DuvanRamirez/CubeSat_UD34/P2 – OBC-ADCS/Entregas/esquematico_P2.pdf

# CubeSat UD34 – PCB P2 OBC-ADCS

## Esquemático completo (Práctica 4) – proyecto Altium P2_OBC-ADCS.PrjPcb

## Autores: Duvan Camilo Ramírez Caro · Daniela Escobar Velandia Fecha: 2026-10-26 · Revisión: v1.0-esquematico

## Contenido

Hoja 2/10 P2_TOP.SchDoc – Hoja principal: bloques e interconexiones (multicanal Repeat(MTQ,1,3) y Repeat(PANEL,1,4)) Hoja 3/10 PWR_IN.SchDoc – Entrada de potencia: J2 (H2 del PC/104), desacoplo de rieles y puntos de prueba
Hoja 4/10 MCU_CORE.SchDoc – MCU STM32H743IIT6 (U1A, U1B, U1C), cristal HSE, SWD (J9), desacoplo, VDDA/VREF+ Hoja 5/10 MEMORY.SchDoc – SDRAM IS42S16160L (FMC), eMMC IS21EF04GP (SDMMC1) y NOR W25Q128JV (QUADSPI)

### Hoja 6/10 CAM_IF.SchDoc – Interfaz de cámara: J3 FFC de 40 pines a la P4, pull-ups I2C3

Hoja 7/10 ADCS_SENS.SchDoc – Sensores: IMU ISM330DHCX (SPI1), magnetómetro LIS2MDL y RTC RV-3032 (I2C2) Hoja 8/10 BUS_IF.SchDoc – Bus del satélite J1 (H1 del PC/104), ruedas de reacción J8, pull-ups y puntos de prueba

### Hoja 9/10 MTQ_CH.SchDoc – Canal de magnetorquer (×3): DRV8837 + INA180A2 + shunt 0,47 Ω

Hoja 10/10 PANEL_CH.SchDoc – Canal de panel (×4): conector JST GH, filtros RC de sensores solares, bobina

Nota: las hojas de este documento son capturas de pantalla del editor de Altium Designer (2026-10-26), no la exportación Smart PDF.
Los canales repetidos (MTQ1–MTQ3, PANEL1–PANEL4) se muestran con su hoja única; la versión exportada se reemplazará en la siguiente revisión.


P2 OBC-ADCS · P2_TOP.SchDoc | Hoja principal: bloques e interconexiones (multicanal Repeat(MTQ,1,3) y Repeat(PANEL,1,4))
CubeSat UD34 · Ramírez Caro, Escobar Velandia · 2026-10-26 · v1.0-esquematico | Hoja 2 de 10


P2 OBC-ADCS · PWR_IN.SchDoc | Entrada de potencia: J2 (H2 del PC/104), desacoplo de rieles y puntos de prueba
CubeSat UD34 · Ramírez Caro, Escobar Velandia · 2026-10-26 · v1.0-esquematico | Hoja 3 de 10

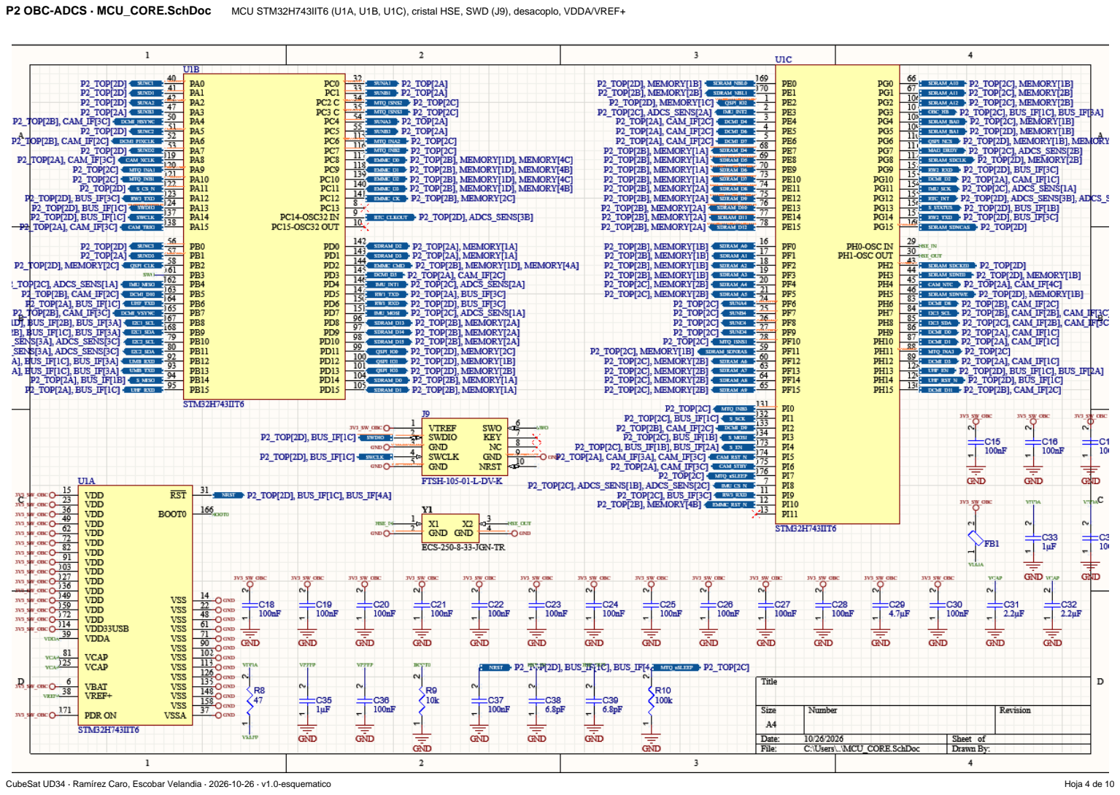
[picture p16: page 4]

P2 OBC-ADCS · MCU_CORE.SchDoc | MCU STM32H743IIT6 (U1A, U1B, U1C), cristal HSE, SWD (J9), desacoplo, VDDA/VREF+
CubeSat UD34 · Ramírez Caro, Escobar Velandia · 2026-10-26 · v1.0-esquematico | Hoja 4 de 10

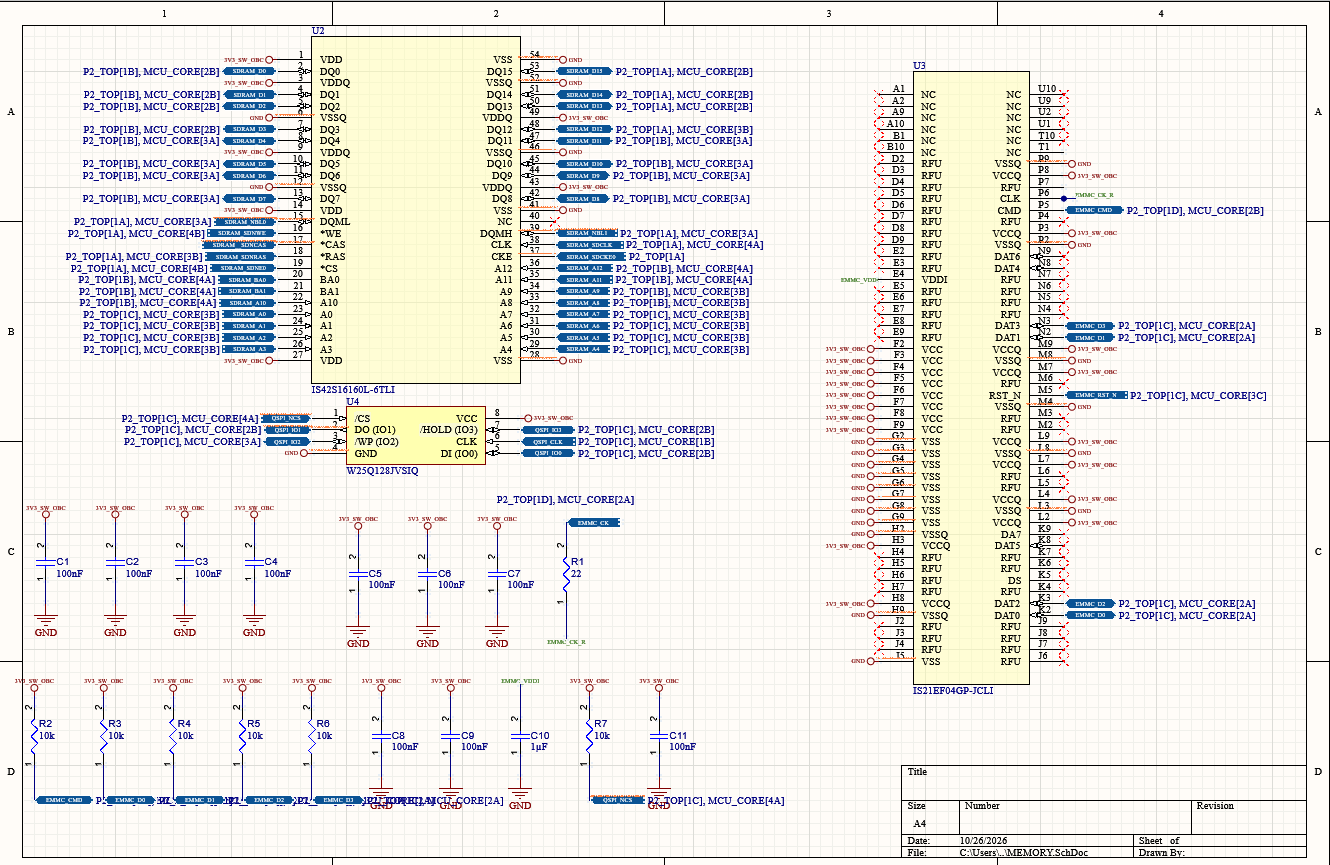
[picture p17: page 5]

P2 OBC-ADCS · MEMORY.SchDoc | SDRAM IS42S16160L (FMC), eMMC IS21EF04GP (SDMMC1) y NOR W25Q128JV (QUADSPI)
CubeSat UD34 · Ramírez Caro, Escobar Velandia · 2026-10-26 · v1.0-esquematico | Hoja 5 de 10


P2 OBC-ADCS · CAM_IF.SchDoc | Interfaz de cámara: J3 FFC de 40 pines a la P4, pull-ups I2C3
CubeSat UD34 · Ramírez Caro, Escobar Velandia · 2026-10-26 · v1.0-esquematico | Hoja 6 de 10


P2 OBC-ADCS · ADCS_SENS.SchDoc Sensores: IMU ISM330DHCX (SPI1), magnetómetro LIS2MDL y RTC RV-3032 (I2C2)

CubeSat UD34 · Ramírez Caro, Escobar Velandia · 2026-10-26 · v1.0-esquematico | Hoja 7 de 10


P2 OBC-ADCS · BUS_IF.SchDoc | Bus del satélite J1 (H1 del PC/104), ruedas de reacción J8, pull-ups y puntos de prueba
CubeSat UD34 · Ramírez Caro, Escobar Velandia · 2026-10-26 · v1.0-esquematico | Hoja 8 de 10


P2 OBC-ADCS · MTQ_CH.SchDoc | Canal de magnetorquer (×3): DRV8837 + INA180A2 + shunt 0,47 Ω
CubeSat UD34 · Ramírez Caro, Escobar Velandia · 2026-10-26 · v1.0-esquematico | Hoja 9 de 10


P2 OBC-ADCS · PANEL_CH.SchDoc | Canal de panel (×4): conector JST GH, filtros RC de sensores solares, bobina
CubeSat UD34 · Ramírez Caro, Escobar Velandia · 2026-10-26 · v1.0-esquematico | Hoja 10 de 10
