DuvanRamirez/CubeSat_UD34/Diagramas/diagrama_arquitectura.png

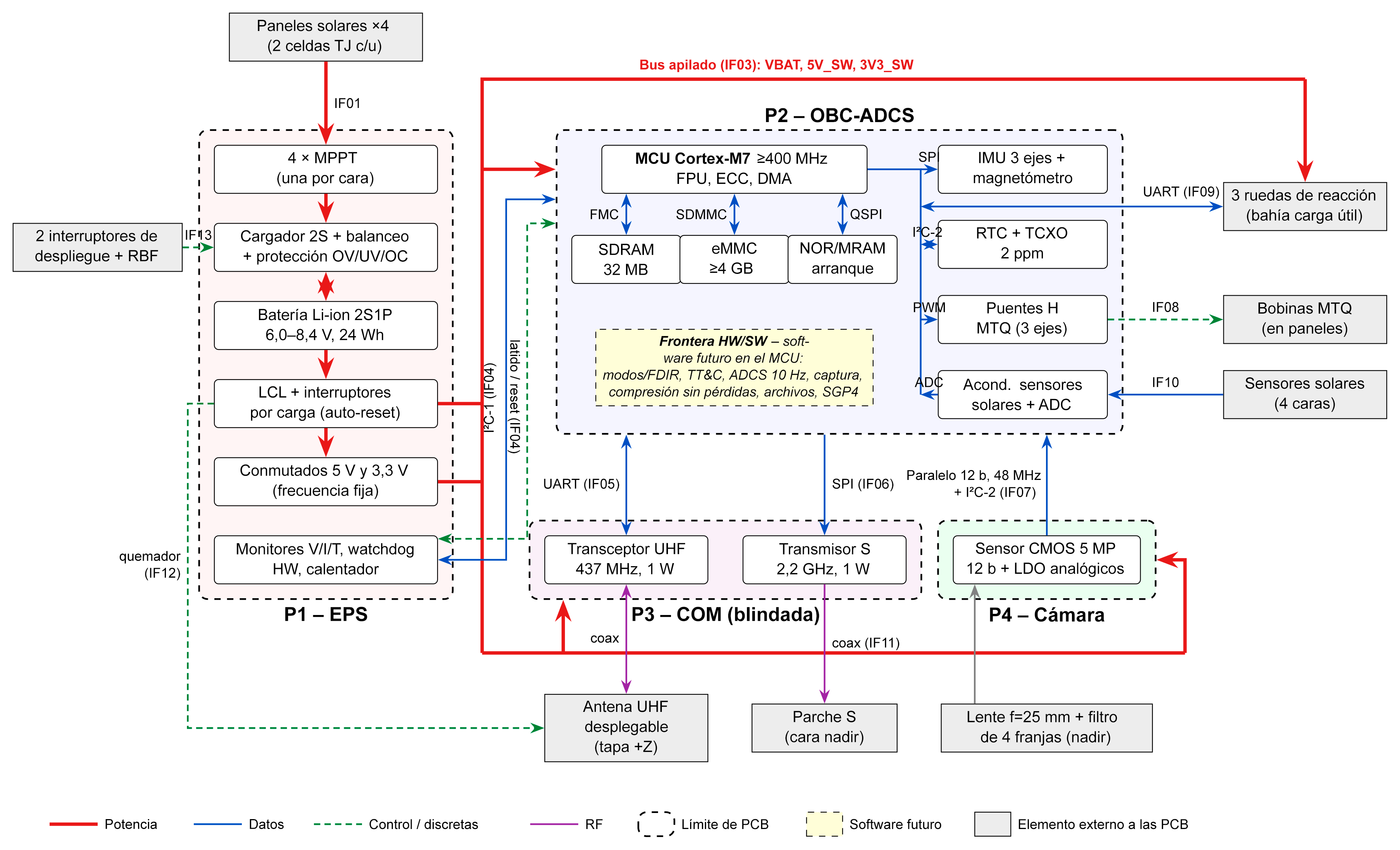
Diagramas/diagrama_arquitectura.png
