DuvanRamirez/CubeSat_UD34/Hoja_calculo/Hoja_Calculo.xlsx

Sheet: Leeme
CubeSat UD34 – Práctica 3: hoja de cálculo de soporte
Contiene las matrices, la comparación de alternativas y los presupuestos del informe.
Convención de colores: texto azul = dato de entrada editable; negro = fórmula; verde = vínculo a otra hoja; relleno amarillo = supuesto clave.
Hojas: Parametros (entradas y cálculos de órbita y carga útil) · Requisitos · Especificaciones · Trazabilidad · HW_SW · Recursos · Alternativas · Matriz (ponderada y sensibilidad) · Potencia · Masa_Volumen · Datos · Enlace · Interfaces · Riesgos.
Referencias entre corchetes: [proyecto] descripción del proyecto UD34; [cds] CubeSat Design Specification Rev. 14.1; [soapwr], [soagnc], [soaav], [soacom] NASA State-of-the-Art, cap. 3, 5, 8 y 9; [ecss20], [ecssemc], [ecsspcb] normas ECSS; [nasa41], [nasa42] NASA SE Handbook.
Los contactos con Medellín (pases/día y minutos/día) provienen de la propagación de 10 días en calculos.py; aquí se ingresan como dato.

Sheet: Parametros
Parámetro | Valor | Unidad | Fuente / fórmula
Parámetro gravitacional terrestre μ | 398600.442 | km³/s² | Constante
Radio terrestre ecuatorial | 6378.137 | km | Constante
Coeficiente J2 | 0.001 | - | Constante
Altitud orbital | 550 | km | [proyecto]
Semieje mayor | 6928.137 | km | Re + h
Período orbital | 95.650 | min | 2π√(a³/μ)
Velocidad de la traza | 6.983 | km/s | √(μ/a)·Re/a
Inclinación heliosíncrona | 97.593 | ° | Precesión nodal J2 = 360°/año
Fracción de eclipse (β = 0) | 0.372 | - | Peor caso (S-02)
Duración del eclipse | 35.611 | min
Órbitas por día | 15.055 | -
Tamaño de píxel | 2.200 | µm | Sensor CMOS 5 MP (ET-05)
Distancia focal | 25 | mm | Lente (ET-03)
Columnas leídas (ventana) | 1296 | px | ET-04
Filas del sensor | 1944 | px | ET-05
Bits por píxel | 12 | bit | ET-02
Número de bandas | 4 | - | RF-01
GSD en nadir | 48.400 | m | H·p/f (Ec. 1)
Ancho de franja | 62.726 | km | Ncol·GSD
Filas por banda | 486.000 | px
Longitud de franja por banda | 23.522 | km
Datos por toma (crudo) | 3.779 | MB
Intervalo entre tomas | 3 | s | ET-06
Duración de la escena objetivo | 60 | s | ET-06
Tomas por sesión | 26.000 | - | Escena + barrido de las 4 franjas
Razón de compresión sin pérdidas | 2 | - | S-05
Volumen por sesión (comprimido) | 49.129 | MB
Traslape entre tomas | 0.109 | - | Debe ser > 0
Exposición máxima | 3.466 | ms | Ec. 2
Reloj de píxel | 48 | MHz | ET-07
Tiempo de lectura | 52.488 | ms
Estabilidad máxima | 0.048 | °/s | Ec. 3
Cizalla por rolling shutter | 7.573 | px | Se corrige en tierra
Ciclos por muestra de compresión | 700 | ciclos | S-06 (Emporda: 550-710)
Reloj de CPU | 400 | MHz | ET-10
Tiempo de compresión por toma | 4.409 | s
Compresión de una sesión (diferida) | 1.911 | min | Debe terminar antes del siguiente contacto
Desplazamiento por 2° de error | 19.206 | km | RNF-07
Pases por día sobre Medellín (el ≥ 10°) | 2.200 | pases/día | calculos_ud34.py (10 días)
Tiempo de contacto por día | 15.400 | min/día | calculos_ud34.py (10 días)
Fracción útil del contacto para banda S | 0.500 | - | Presupuesto de datos
Eficiencia de trama | 0.850 | - | Presupuesto de datos
Tasa de banda S | 1 | Mbps | ET-12
Capacidad útil de banda S | 49.087 | MB/día | ET-14
Tiempo S por sesión | 7.706 | min
Sesiones por semana | 4 | - | S-07

Sheet: Supuestos
ID | Supuesto | Justificación / consecuencia
S-01 | Órbita circular heliosíncrona de 550 km, i=97,6°, hora local del nodo descendente 10:30. | i calculada con la condición de precesión nodal J_2 (archivos de soporte). Coincide con la de AlAinSat-1, en SSO a 550 km (i=97,565°) [alainsat]. La hora 10:30 es la de Sentinel-2, elegida como compromiso entre iluminación y nubosidad [s2orbit].
S-02 | Eclipse de peor caso: 35,6 min de 95,6 min (β=0). | Dimensiona batería y promedio de generación de forma conservadora.
S-03 | Estación de referencia en Medellín (6,25°N, 75,56°W), elevación mínima 10°; UHF: Yagi 16,3 dBi, 120 W, receptor con NF 2 dB; banda S: parábola de 2 m con G/T=4,9 dB/K. | La estación no se diseña; se toman los parámetros de un kit comercial de estación para pequeños satélites [isisgs,ntnugs]. La antena UHF se toma a T_0=290 K (conservador). Si solo hubiera parábola de 1,2 m, ver riesgo R-05.
S-04 | No se usa receptor GNSS; la posición se propaga a bordo con SGP4 a partir de TLE cargados desde tierra. | El error de TLE+SGP4 crece del orden de 1--3 km/día [sgp4]; con TLE nuevos cada ≤48 h el error queda ≤7 km, menor que media franja (31 km). Se ahorra la potencia y el volumen de un receptor.
S-05 | Compresión sin pérdidas a bordo con razón 2:1. | CCSDS-123 es el estándar de compresión sin pérdidas para imágenes multiespectrales [ccsds120]; su implementación en ECOSTRESS logra típicamente 2,3:1 [kiely]. Con una razón de solo 1,5:1 una sesión ocupa 65,5 MB, se descarga en 1,3 días (<2, RNF-05) y 7 días ocupan 0,46 GB (<1 GB, ET-08): la arquitectura no cambia.
S-06 | Costo de compresión en software de 700 ciclos de reloj por muestra. | La implementación de referencia de CCSDS-123 (Emporda) procesa ≈4,9 Msamples/s en un i7-7500U con 15 bandas de predicción [fjeldtvedt], es decir, ≈550--710 ciclos/muestra; se toma el valor alto. La compresión se hace después de la sesión desde memoria (Tabla recursos), por lo que un costo mayor solo alarga ese tiempo.
S-07 | Operación nominal de 4 sesiones de captura por semana; picos de 1 sesión/día. | Coherente con la capacidad de descarga (Sección presupuestos) y con la nubosidad de la zona.
S-08 | Consumos, masas y tamaños tomados de productos de la misma clase: Tablas 3-1, 3-4 y 3-8 [soapwr], 5-3 a 5-7 [soagnc], 8-4 [soaav], 9-2 y 9-3 [soacom] y hojas de datos de referencia (Tabla pot). | Nivel suficiente para demostrar viabilidad; se añade 20 % de margen. La masa de la óptica es la única estimación propia.
S-09 | Temperatura interna de operación entre -20 °C y +50 °C. | Es el rango de ciclado térmico del estándar QB50 usado para CubeSats [alainsat] y el rango de operación exigido a radios CubeSat de NASA [altunc]. No se hace análisis térmico (no exigido [proyecto]).
S-10 | Altura útil de apilado interno de 95 mm. | Una estructura 1U comercial ofrece un volumen interior de 98,4 mm de altura [spacemanic]; se reservan 3,4 mm para holguras y fijaciones. Condiciona la partición física (R-01).
S-11 | Misión de 6 meses en LEO: componentes COTS de rango industrial con mitigación de efectos de evento único. | Práctica usual en CubeSats; hay OBC Cortex-M7 comerciales probados hasta 40 krad, y las mitigaciones recomendadas son watchdog, ECC y reinicio de alimentación [soaav]. El proyecto no exige análisis de radiación [proyecto].
S-12 | Registro entre bandas, corrección geométrica y calibración radiométrica se realizan en tierra. | Libera al OBC de procesamiento de imagen complejo.
S-13 | Para BER 10^-5: bajada UHF GMSK con detección coherente, E_b/N_0=9,6 dB; bajada S con QPSK y código convolucional (7,1/2), 4,1 dB; subida UHF, sensibilidad del receptor de -104 dBm (FSK, 9,6 kbps). | MSK con detección coherente tiene el desempeño de BPSK y GMSK con BT=0,5 lo degrada poco [murota]; el código (7,1/2) gana ≈5,5 dB sobre el caso sin codificar (9,6 dB) [ccsds130]; la sensibilidad es la de un transceptor CubeSat comercial [trxvu]. Con 1 dB adicional de pérdida de implementación todos los márgenes siguen ≥3 dB.
S-14 | Consumo de las radios: transmisor UHF 5,5 W a 30 dBm; transmisor S 5 W a 30 dBm; receptor UHF 0,24 W. | Transceptores UHF comerciales consumen 3--5,5 W para 27--33 dBm (se toma el máximo) [pulsarvutrx] y <0,24 W en recepción [pulsarutrx]; un transmisor S de 2,2--2,3 GHz con QPSK y 1 Mbps útiles con r=1/2 consume <5 W a 30 dBm [pulsarstx].

Sheet: Requisitos
ID | Tipo | Requisito | Origen / justificación | Pr. | Criterio de aceptación (método)
Funcionales
RF-02 | F | El satélite deberá ejecutar sesiones de captura programadas desde tierra por tiempo y objetivo. | ConOps; las zonas cafeteras solo son visibles en algunos pases. | A | Plan con 3 capturas ejecutado en banco con tiempo simulado, error de disparo ≤10 ms (D).
RF-03 | F | El satélite deberá conservar imágenes y telemetría en memoria no volátil hasta confirmar su descarga. | Contactos intermitentes (≈2,2 pases/día). | A | Sin pérdida de archivos tras 10 cortes de energía durante escritura (P).
RF-04 | F | El satélite deberá transmitir los datos de imagen a la estación de Medellín. | Misión. | A | Transferencia de extremo a extremo con atenuador que reproduce la pérdida de ET-12, tasa de error de trama <10^-3 (P).
RF-05 | F | El satélite deberá transmitir telemetría de tensiones, corrientes, temperaturas, modo y estado de subsistemas. | Descripción del proyecto. | A | Todas las variables de la lista de telemetría presentes en la baliza y en el volcado (D).
RF-06 | F | El satélite deberá recibir, validar y ejecutar telecomandos y reportar su ejecución. | Descripción del proyecto. | A | 100 % de comandos válidos ejecutados y reconocidos; comandos corruptos rechazados (P).
RF-07 | F | El satélite deberá estimar su actitud. | Apuntar cámara, antena y paneles. | A | Sensores entregan datos a la tasa de ET-17; estimación verificada por simulación (A, P).
RF-08 | F | El satélite deberá modificar su actitud para amortiguar la rotación, apuntar la cámara, apuntar la antena a la estación y exponer los paneles al Sol. | Descripción del proyecto. | A | Polaridad y par de actuadores medidos (P); desempeño por simulación (A).
RF-09 | F | El satélite deberá generar energía solar y almacenarla para operar en eclipse. | Descripción del proyecto. | A | Carga de batería con simulador solar en rango de ET-19/20 (P).
RF-10 | F | El satélite deberá permitir encender y apagar por comando cada subsistema no crítico. | Gestión de energía y recuperación de fallas. | A | Cada salida conmutada responde a comando (P).
RF-11 | F | El satélite deberá proteger cada línea de alimentación contra sobrecorriente y restablecerla automáticamente. | Latch-up por radiación [soaav]; ECSS-E-ST-20 §5.8.1d,e [ecss20]. | A | Corto inducido: disparo y reconexión en tiempos de ET-22 sin afectar otras líneas (P).
RF-12 | F | El satélite deberá mantener la hora y estimar su posición orbital a bordo. | Programar capturas y pases sin GNSS (S-04). | M | Error de hora dentro de RNF-13 (P); SGP4 comparado con referencia (A).
RF-13 | F | El satélite deberá pasar autónomamente a modo seguro ante batería baja, bloqueo del OBC o 48 h sin comandos. | Protección de la misión. | A | Inyección de las tres fallas produce transición a modo seguro (D).
RF-14 | F | El satélite deberá pasar de configuración de lanzamiento a operativa de forma autónoma tras la separación. | Antena UHF plegada durante el lanzamiento. | A | Secuencia completa en banco activando los interruptores de despliegue (D).
No funcionales
RNF-02 | NF | El ancho de franja por banda deberá ser ≥50 km. | Absorber el error de apuntamiento (19 km a 2°) y cubrir la región en un pase. | A | Cálculo con número de columnas (A).
RNF-03 | NF | La resolución radiométrica deberá ser ≥10 bits. | Diferencias pequeñas de reflectancia entre estados de vegetación. | M | Hoja de datos del sensor (I).
RNF-04 | NF | El almacenamiento deberá guardar ≥7 días de capturas nominales sin descarga. | Pérdida de pases o indisponibilidad de la estación. | A | Capacidad útil ≥ ET-08 (A, I).
RNF-05 | NF | El sistema deberá descargar el volumen de una sesión en ≤2 días de contactos. | Equilibrio entre generación y descarga de datos (MOE-2). | A | Presupuesto de enlace y contactos (A).
RNF-06 | NF | Todos los enlaces deberán tener margen ≥3 dB a 10° de elevación. | Margen estándar de enlace usado por NASA para CubeSats [altunc]. | A | Presupuesto de enlace (A).
RNF-07 | NF | El error de apuntamiento de la cámara deberá ser ≤2° (3σ) durante la captura. | Desplazamiento ≤19 km, menor que media franja. | A | Simulación ADCS con sensores de ET-17 (A).
RNF-08 | NF | La estabilidad angular durante la captura deberá ser ≤0,04 °/s. | Cizalla por lectura rolling < GSD/2 (Ec. est). | A | Simulación ADCS (A).
RNF-09 | NF | El balance de energía diario deberá ser positivo con margen de 20 % sobre el consumo en el perfil de peor caso. | Viabilidad energética. | A | Presupuesto de potencia (A).
RNF-10 | NF | La profundidad de descarga de la batería deberá ser ≤20 % en la órbita de peor caso. | ≈2750 ciclos en 6 meses. | M | Presupuesto (A); ciclo de carga en banco (P).
RNF-11 | NF | El satélite deberá cumplir sus funciones durante al menos 6 meses. | Supuesto obligatorio de la misión. | A | Degradación de paneles y ciclos de batería incluidos en los presupuestos (A).
RNF-12 | NF | El procesamiento deberá ejecutar el control de actitud a ≥10 Hz con carga de CPU ≤70 % durante la captura y comprimir una sesión antes del siguiente contacto. | Margen para el software futuro [soaav]. | A | Estimación (A) y medición en tarjeta de evaluación (P).
RNF-13 | NF | El error de la hora a bordo deberá ser ≤0,5 s entre sincronizaciones. | 1 s de error equivale a 7 km a lo largo de la traza. | M | Deriva medida en 48 h (P).
RNF-14 | NF | Un supervisor independiente deberá reiniciar el OBC en ≤30 s si deja de responder. | El OBC es un punto único de falla. | A | Bloqueo forzado del OBC (P).
RNF-15 | NF | Cada PCB deberá poder alimentarse, programarse y probarse de forma independiente. | Integración y prueba (Práctica 6). | M | Prueba de cada tarjeta aislada con fuente de banco (D).
Ambientales
RA-02 | Am | El hardware deberá disipar su calor sin convección. | Vacío. | A | Elementos >0,5 W con camino térmico a estructura (A, I).
RA-03 | Am | El hardware deberá tolerar SEL y SEU sin pérdida permanente de funciones durante la misión. | Radiación en LEO; SEL destructivo en COTS [soaav]. | A | Mitigaciones de ET-22 y ET-24 implementadas (I); prueba de corto inducido (P).
RA-04 | Am | El hardware deberá soportar la vibración y el choque del lanzamiento. | CDS §3.1, §3.3 [cds]. | A | Niveles del proveedor o GEVS; en el curso: sujeción de componentes pesados (I).
RA-05 | Am | Las emisiones internas no deberán degradar la sensibilidad del receptor UHF más de 1 dB. | Pequeño frente al margen UHF (12,4 dB). ECSS-E-ST-20-07 [ecssemc]. | A | Piso de ruido con todos los subsistemas encendidos (P).
Normativos
RN-02 | N | Masa ≤2,00 kg y centro de masa a ±2 cm del centro geométrico. | CDS §2.2.10, §2.2.11. | A | Pesaje y cálculo de CG (I, A).
RN-03 | N | Energía cortada desde la entrega hasta el despliegue por interruptor(es) de despliegue y pin RBF; reinicio a estado de prelanzamiento si el interruptor conmuta. | CDS §2.3.1, §2.3.2, §2.3.5. | A | Prueba de continuidad y de secuencia (P).
RN-04 | N | Tres inhibidores independientes de RF y ninguna emisión antes de 45 min. | CDS §2.3.7, §2.4.5. | A | Inspección del esquema y prueba de temporización (I, P).
RN-05 | N | Tres inhibidores para elementos desplegables y espera ≥30 min. | CDS §2.3.8, §2.4.4. | A | Inspección y prueba (I, P).
RN-06 | N | Protección de carga y descarga de la batería contra celdas desbalanceadas. | CDS §2.3.6. | A | Prueba de protección (P).
RN-07 | N | Uso de frecuencias con licencia o coordinación (UIT, ANE; IARU para aficionados). | CDS §2.4.1, §2.4.2; [soacom]. | A | Trámite documentado (I).
RN-08 | N | Materiales con TML ≤1 % y CVCM ≤0,1 %. | CDS §2.1.7. | M | Lista de materiales contra base NASA (I).
RN-09 | N | Mitigación de desechos: componentes que reingresen con <15 J. | CDS §2.4.3. | M | Análisis con DAS (A).
RN-10 | N | Diseño eléctrico y de PCB conforme, como guía, a ECSS-E-ST-20C, ECSS-E-ST-20-07C y ECSS-Q-ST-70-12C. | Buenas prácticas [ecss20,ecssemc,ecsspcb]. | M | Lista de verificación en revisión de diseño (I).

Sheet: Especificaciones
ID | Requisitos | Parámetro | Valor / rango (unidad) | Fundamento | Verificación
ET-01 | RF-01 | Bandas (centro/ancho) | 560/35, 665/30, 705/15, 842/115 nm | Bandas visibles e infrarrojas para vegetación [proyecto]. Centros y anchos iguales a las bandas B3, B4, B5 y B8 de Sentinel-2 [s2bands,s2hub], lo que permite comparar los índices con ese sensor: verde, rojo (absorción de la clorofila), borde rojo y NIR. | I (filtro)
ET-02 | RNF-03 | Cuantización | 12 bits | Supera el mínimo de 10 bits; ADC de 12 bits del sensor de referencia [mt9p031]. | I
ET-03 | RNF-01 | GSD nadir | 48,4 m (±1 m por tolerancia de focal ±2 %) | Ec. gsd. | A
ET-04 | RNF-02 | Franja | 62,7 km (1296 columnas) | 1296×GSD; margen de 25 %. | A
ET-05 | RF-01, RF-02 | Toma | 1296×1944 px, 4 franjas de 486 filas, 3,78 MB | Sensor de 2592×1944 px de 2,2 µm con lectura por ventana [mt9p031]; 12 bits empaquetados. | A
ET-06 | RF-02, RNF-01 | Exposición / intervalo / sesión | ≤3,5 ms / 3 s / 26 tomas (≈75 s) | Ec. exp; avance 20,9 km < franja de banda 23,5 km (11 % traslape). | A, D
ET-07 | RF-01 | Interfaz de la cámara | Paralela 12 bits, PIXCLK ≤48 MHz, HSYNC/VSYNC; configuración I2C | 48 Mp/s con E/S de 1,8 V [mt9p031]; 96 MB/s por DMA a SDRAM; lectura 52 ms. | P
ET-08 | RF-03, RNF-04 | Almacenamiento masivo | ≥1 GB útil, no volátil con ECC | 7 días × 49 MB + telemetría = 347 MB, margen ×3 (bloques dañados, copias). | A
ET-09 | RNF-12 | RAM de trabajo externa | ≥16 MB (se elige 32 MB, 16 bits) | 3 tomas de 5,04 MB en palabras de 16 bits (doble búfer + compresión). | A
ET-10 | RNF-12 | Capacidad de CPU | ≥400 MHz clase Cortex-M7 con FPU; carga en captura ≈10 %; compresión de una sesión ≤3 min | S-06: 700×1296×1944 ciclos = 4,4 s/toma, 26 tomas en ≈2 min en segundo plano; ADCS y C&DH con 10 % reservado (≈85 de 856 DMIPS a 400 MHz [stm32]). | A, P
ET-11 | RNF-12, RNF-14 | Memoria de programa | ≥1 MB con ECC + 2 imágenes de arranque | Dos imágenes de arranque (RNF-14); MCU de referencia con 2 MB de flash y 1 MB de RAM [stm32]. | I
ET-12 | RF-04, RNF-05/06 | Enlace de datos | 2200--2290 MHz, 1 Mbps, QPSK + FEC r=1/2, 30 dBm; margen 4,8 dB | Ec. link, Tabla link; transmisores S de 27--33 dBm en 2200--2290 MHz y parches de 6 dBi (Tablas 9-2 y 9-3) [soacom,pulsarstx]. | A
ET-13 | RF-05/06, RNF-06 | Enlace TT&C | 435--438 MHz, semidúplex, 9,6 kbps (bajada GMSK, subida FSK), 30 dBm; márgenes 12,4 dB (bajada) y 12,7 dB (subida) | Tabla link; transceptores UHF de 27--33 dBm a 9,6 kbps (Tabla 9-3) [soacom,pulsarutrx]. | A
ET-14 | RNF-05 | Volumen descargable | ≥49 MB/día (50 % de contactos útiles) | Una sesión en 7,7 min de banda S; 4 sesiones/semana usan 57 %. | A
ET-15 | RNF-07 | Apuntamiento | ≤2° (3σ); conocimiento ≤1°; hasta 30° fuera de nadir | Ec. geométrica H; seguimiento de estación a ≤0,8 °/s. | A
ET-16 | RNF-08, RF-08 | Estabilidad y actuación fina | ≤0,04 °/s; 3 ruedas con ≥0,5 mNms c/u | Ec. est. Seguimiento requiere I=0,03 mNms (I≈0,002 kg·m²): margen >10. Ruedas de 0,58 mNms, ≤25 g (Tabla 5-3) [soagnc]. | A
ET-17 | RF-07 | Sensores de actitud | Magnetómetro y giróscopo 3 ejes a ≥10 Hz; sensores solares en 4 caras, ≤1° | Las capturas ocurren siempre con Sol: Sol + campo magnético dan actitud 3 ejes. Hay sensores solares analógicos de 0,2° sin consumo y magnetómetros de 0,01--0,23 W (Tablas 5-6 y 5-7) [soagnc]. | P
ET-18 | RF-08 | Magnetorquers | 3 ejes, ≥0,2 A·m² | Par mB=6 µN·m (B≈30 µT); frena 10°/s en <1 órbita. Existen de 0,2 A m², 16,5 g, 0,49 W (Tabla 5-4) [soagnc]. | A
ET-19 | RF-09, RNF-09 | Generación | 4 caras × 2 celdas TJ ≥29,5 %: 2,42 W/cara BOL; 1,51 W promedio EOL | Ec. pgen; 3G30-Adv, 29,5 % (Tabla 3-1) [soapwr]. | A, P
ET-20 | RF-09, RNF-10 | Batería | Li-ion 2S1P (18650), 6,0--8,4 V, ≥23 Wh; DoD peor órbita 11 % | Eclipse + déficit de peor órbita = 2,6 Wh; NCR18650B de 3350 mAh (Tabla 3-4) [soapwr] ⇒ 24,1 Wh. | A, P
ET-21 | RF-10 | Rieles | VBAT 6,0--8,4 V; 5,0 V ±3 % ≥1,2 A; 3,3 V ±3 % ≥1,0 A; rizado ≤30 mV_pp | Cargas pico 5 V: 0,58 A; 3,3 V: 0,45 A; factor 2. Radios en VBAT. | P
ET-22 | RF-11, RA-03 | Limitadores (LCL) | Uno por carga; umbral 1,3--1,5× I_max; disparo ≤1 ms; reconexión automática tras 100 ms | ECSS-E-ST-20 §5.8.1d (protección en la fuente) y §5.8.1e (sin desconexión permanente por SEE) [ecss20]. | P
ET-23 | RF-12, RNF-13 | Base de tiempo | RTC con TCXO ≤2 ppm; sincronización ≤ cada 48 h | Deriva máx. 0,35 s en 48 h. | P
ET-24 | RNF-14, RF-13 | Supervisión | Latido I2C OBC→EPS cada ≤10 s; EPS reinicia el OBC a los 30 s; watchdog interno del MCU | Supervisor en otra tarjeta y otro dominio de energía [soaav]. | P
ET-25 | RN-03/04/05 | Inhibidores | 2 interruptores de despliegue (lado alto y bajo) + RBF; interruptor FET dedicado en radios y en quemador de antena | Tres dispositivos físicos por riesgo; el temporizador no cuenta como inhibidor [cds]. | I, P
ET-26 | RN-01/02 | Envolvente y masa | 100×100×113,5 mm; masa estimada 1,29 kg con 20 % de margen | Tabla pot. | I
ET-27 | RA-01 | Rangos térmicos | Componentes ≥-40/+85 °C; carga de batería solo entre 0 y 45 °C; calentador activo <5 °C | Rango industrial cubre S-09; límites típicos de carga Li-ion [soapwr]. | I, A
ET-28 | RA-05 | EMC de convertidores | Frecuencia de conmutación fija y sincronizable ≥500 kHz; COM con blindaje y plano de tierra continuo | Evita espurias variables en la banda de 437 MHz; ECSS-E-ST-20-07 [ecssemc]. | P

Sheet: Trazabilidad
Req. | ET | Bloque | Req. | ET | Bloque
RF-01 | 01, 05, 07 | P4, P2 | RNF-06 | 12, 13 | P3, antenas
RF-02 | 05, 06 | P2, P4 | RNF-07 | 15, 17 | P2, ruedas
RF-03 | 08 | P2 | RNF-08 | 16 | P2, ruedas
RF-04 | 12 | P3, parche S | RNF-09 | 19, 21 | P1, paneles
RF-05 | 13 | P3, P2 | RNF-10 | 20 | P1
RF-06 | 13 | P3, P2 | RNF-11 | 19, 20, 22 | Sistema
RF-07 | 17 | P2, paneles | RNF-12 | 09, 10, 11 | P2
RF-08 | 15, 16, 18 | P2, ruedas, MTQ | RNF-13 | 23 | P2
RF-09 | 19, 20 | P1, paneles | RNF-14 | 24 | P1, P2
RF-10 | 21 | P1 | RNF-15 | Tabla if (IF14) | Todas
RF-11 | 22 | P1 | RA-01 | 27 | Todas
RF-12 | 23 | P2 | RA-02 | 26, 28 | Todas
RF-13 | 24 | P1, P2 | RA-03 | 22, 24 | P1, P2
RF-14 | 25 | P1, antena | RA-04, RN-01, RN-02 | 26 | Estructura
RNF-01 | 03 | P4 | RA-05 | 28 | P1, P3
RNF-02 | 04 | P4 | RN-03 a RN-06 | 20, 25 | P1
RNF-03 | 02 | P4 | RN-10 | 21, 22, 28 | Todas
RNF-04, 05 | 08, 14 | P2, P3 | RN-07, 08, 09 | -- (documental) | Proyecto

Sheet: HW_SW
Función | Tipo | Recursos de hardware | Responsabilidad del software futuro | Justificación
Generación y carga | HW | MPPT por cara, cargador 2S con balanceo, protección OV/UV/OC | Solo leer telemetría y ajustar consignas | Debe operar sin OBC (modo seguro, arranque).
Distribución y protección | Mixta | LCL con reconexión automática, sensores de corriente, interruptores de carga | Encender/apagar cargas, registrar eventos de disparo | La protección es HW (tiempo de µs--ms); la política es SW.
Supervisión y modos (FDIR) | Mixta | Watchdog interno + watchdog en EPS, contador de reinicios | Máquina de estados de modos, detección de fallas, paso a modo seguro | Evita que un SEU deje el satélite bloqueado.
TT&C | Mixta | Transceptor UHF, antena, UART | Tramas AX.25/CCSDS, validación, cola de comandos, balizas | Radio integrada; protocolo cambiante en SW.
Captura de imagen | Mixta | Sensor, lente, filtro, interfaz paralela + DMA, SDRAM, temporizador de disparo | Configurar exposición y ganancia, planificar, marcar tiempo | El flujo de 96 MB/s solo es posible por DMA; el disparo usa temporizador HW.
Compresión y archivo | SW | CPU con FPU, SDRAM, eMMC | Compresión sin pérdidas, catálogo, sistema de archivos con registro, miniaturas | ≈2 min por sesión en segundo plano; evita un procesador dedicado.
Descarga de imágenes | Mixta | Transmisor S, parche, SPI | Segmentar, entramar (CCSDS TM), retransmisión selectiva, programar pases | Tasa fija en HW; gestión de archivos en SW.
Determinación de actitud | Mixta | IMU, magnetómetro, sensores solares, ADC | Filtro de estimación, modelos de campo (IGRF) y Sol | Algoritmos no se implementan; HW entrega datos a ≥10 Hz.
Control de actitud | Mixta | Puentes H + bobinas, 3 ruedas con controlador propio | B-dot, apuntamiento, seguimiento de estación, desaturación | Lazo a 10 Hz en OBC; control de velocidad de ruedas local.
Tiempo y órbita | Mixta | RTC con TCXO y respaldo | SGP4, sincronización con tierra | Sin GNSS (S-04).
Térmico de batería | HW + SW | Calentador y termostato HW, NTC | Ajustar consigna y leer temperatura | Carga segura aun sin OBC.
Secuencia post-despliegue | Mixta | Interruptores de despliegue, RBF, FET del quemador | Temporizadores 30/45 min, verificación de despliegue | Los inhibidores son físicos (CDS).

Sheet: Recursos
Recurso | Necesidad derivada de las funciones | Especificación resultante
Procesamiento | Compresión diferida de 4,4 s/toma, ≈2 min/sesión (S-06); ADCS a 10 Hz, SGP4 a 1 Hz, C&DH y protocolos dentro del 10 % reservado. | Cortex-M7 ≥400 MHz con FPU (ET-10); carga en captura ≈10 %.
RAM | Búfer de tomas (5,04 MB c/u), pila RTOS, filtros ADCS (<256 kB). | 1 MB interna con ECC + 32 MB SDRAM (ET-09).
Memoria de programa | RTOS + aplicación + 2 imágenes de arranque. | ≥1 MB interna con ECC + NOR/MRAM externa (ET-11).
Almacenamiento | 7 días de capturas y telemetría = 347 MB. | eMMC ≥1 GB útil (ET-08).
Interfaces | Cámara paralela; SDRAM; eMMC; 2 buses I2C (EPS / sensores separados); UART UHF; SPI banda S y SPI IMU; UART ruedas; 6 PWM; ≥6 ADC; ≈20 GPIO. | MCU con interfaz de cámara paralela, controlador de memoria externa (SDRAM a 100 MHz), SDMMC y Quad-SPI [stm32]; hay OBC Cortex-M7 de 0,28--0,65 W (Tabla 8-4) [soaav].
Temporización | ADCS 10 Hz; telemetría 1 Hz (registro cada 60 s); baliza cada 30 s; disparo cada 3 s ±1 ms; PIXCLK 48 MHz; SDRAM 100 MHz. | Temporizadores HW para disparo y PWM; RTC para tiempo absoluto.

Sheet: Alternativas
Decisión | Opción A | Opción B | Resultado y razón
D1 Procesamiento | Centralizado: un MCU Cortex-M7 hace C&DH, ADCS, cámara y compresión. | Distribuido: OBC de bajo consumo + procesador de carga útil (SoC ARM+FPGA con Linux y DDR3) + MCU de ADCS. | A. La compresión cabe en el MCU (≈2 min por sesión, en segundo plano); B añade varios vatios al procesar (hasta 6 W en unidades de la Tabla 8-4 [soaav]), una tarjeta y enrutamiento DDR3.
D2 División en PCBs | 4 tarjetas: EPS, OBC-ADCS, COM, cabezal de cámara. | 3 tarjetas: EPS, aviónica integrada (OBC+ADCS+radios), cabezal de cámara. | A. Aísla el PA de banda S (1 W) del magnetómetro y del receptor UHF, y permite probar radios por separado; cuesta ≈13 mm de altura (cabe, Tabla vol).
D3 Comunicación interna | I2C para control/telemetría + enlaces dedicados (paralelo, SPI, UART) para datos. | Bus CAN común a todas las tarjetas. | A. Menos componentes y consumo; el riesgo de bloqueo de I2C se mitiga con dos buses separados, recuperación de bus y reinicio por LCL.
D4 Integración de la carga útil | Cámara integrada: el sensor entrega píxeles directamente al OBC. | Módulo de cámara comercial con procesador y memoria propios (USB/SpaceWire). | A. Menos volumen y potencia; control directo de temporización. B facilita integración pero pocos módulos 1U multiespectrales y costosos.
D5 Potencia | MPPT por cara + bus de batería 2S no regulado + convertidores conmutados en punto de carga. | Transferencia directa de energía (DET) + bus regulado único de 5 V. | A. El punto de máxima potencia cambia con la temperatura de cada cara; el MPPT recupera esa pérdida y el bus no regulado alimenta radios con alta eficiencia.
D6 Paneles | Fijos en 4 caras laterales. | Desplegables (2--4 alas). | A. El balance es positivo con paneles fijos (Tabla pot); B requiere mecanismos y 3 inhibidores más.
D7 Enlaces con tierra | UHF (TT&C) + banda S (imágenes). | Solo UHF. | A. UHF descarga ≈444 kB/día frente a 49 MB por sesión: B incumple RF-04/RNF-05.
D8 ADCS | Magnetorquers + 3 ruedas; sensores solares, magnetómetro, giróscopo. | Solo magnetorquers con los mismos sensores (o con rastreador estelar). | A. Los magnetorquers solos no suelen lograr estabilización en tres ejes [soagnc], que la captura (RNF-07/08) y el apuntamiento de la antena S exigen; un rastreador estelar (0,65 W o más, Tabla 5-5) no es necesario para 2°.

Sheet: Matriz
Criterio | Peso | A | B | Peso (sensib.) | Justificación
Consumo de energía | 25 | 4 | 3 | 10 | A: MCU ≈0,35 W. B: procesador de carga útil de hasta 6 W al procesar, aunque se apague el resto del tiempo (Tabla 8-4) [soaav].
Volumen y masa | 20 | 4 | 2 | 20 | B agrega una tarjeta (≈12 mm): excede la altura disponible (S-10).
Capacidad de procesamiento | 15 | 3 | 5 | 30 | A cumple (captura con ≈10 % de CPU y compresión de una sesión en ≈2 min); B permite procesamiento avanzado (p. ej., detección de nubes) no exigido.
Complejidad y riesgo técnico | 15 | 4 | 2 | 15 | B: DDR3, secuencia de encendido del SoC, Linux y tres firmwares.
Integración y prueba | 10 | 4 | 3 | 10 | A: un solo firmware; B: más interfaces, pero módulos probables por separado.
Integridad de señal y EMC | 10 | 3 | 2 | 10 | A: SDRAM a 100 MHz y bus paralelo a 48 MHz (cortos). B: DDR3 con impedancia controlada y más capas.
Costo y disponibilidad | 5 | 4 | 3 | 5 | MCU y SDRAM de amplia disponibilidad; SoC y DDR3 con más costo.
Suma de pesos | 100 |  |  | 100
Total A (sobre 100) |  | 75
Total B (sobre 100) |  |  | 57
Sensibilidad: total A |  | 72
Sensibilidad: total B |  |  | 63
Escala 1 (malo) a 5 (excelente). Total = Σ(peso × nota)/5. Sensibilidad: peso de procesamiento 30 y de energía 10.

Sheet: Potencia
Entradas de generación y batería
Parámetro | Valor | Unidad | Fuente
Área de celda | 30.18 | cm² | Celda TJ en cara 1U
Eficiencia de celda | 0.295 | - | 3G30-Adv, Tabla 3-1 [soapwr]
Constante solar | 1361 | W/m²
Celdas por cara | 2 | - | ET-19
Factor de temperatura | 0.85 | - | k_deg
Degradación 6 meses | 0.95 | - | k_deg
Eficiencia MPPT y conversión | 0.9 | - | k_deg
Pérdidas de cableado | 0.97 | - | k_deg
Factor geométrico (2 caras a 45°) | 1.41 | - | Actitud nominal
Capacidad de celda | 3.35 | Ah | NCR18650B, Tabla 3-4 [soapwr]
Tensión nominal de celda | 3.6 | V
Celdas en serie | 2 | - | 2S1P
Margen sobre consumo | 0.2 | - | RNF-09
Órbitas de peor caso por día | 3 | - | Perfil de diseño
Potencia por cara BOL | 2.42 | W
Generación promedio orbital EOL | 1.51 | W
Duración de la órbita | 1.594 | h
Energía generada por órbita | 2.41 | Wh
Capacidad de batería | 24.1 | Wh
Subsistema | P nominal (W) | P máxima (W) | Ciclo órbita nominal | Ciclo órbita peor caso | Energía nominal (Wh) | Energía peor caso (Wh) | Fuente
OBC (MCU + memorias) | 0.35 | 0.90 | 100% | 100% | 0.558 | 0.558 | Tabla 8-4 [soaav]
EPS (supervisión) | 0.10 | 0.15 | 100% | 100% | 0.159 | 0.159 | Tablas 3-1, 3-4 [soapwr]
ADCS sensores | 0.12 | 0.15 | 100% | 100% | 0.191 | 0.191 | Tablas 5-6, 5-7 [soagnc]
ADCS magnetorquers | 0.15 | 1.47 | 25% | 25% | 0.060 | 0.060 | Tabla 5-4 [soagnc]
ADCS ruedas (3) | 0.45 | 1.13 | 0% | 25% | 0.000 | 0.179 | Tabla 5-3 [soagnc]
UHF RX | 0.24 | 0.24 | 100% | 100% | 0.383 | 0.383 | Pulsar-UTRX <240 mW [pulsarutrx]
UHF TX (1 W RF) | 5.50 | 5.50 | 2% | 7% | 0.175 | 0.614 | Pulsar-VUTRX 3-5,5 W [pulsarvutrx]
Banda S TX (1 W RF) | 5.00 | 5.00 | 0% | 10% | 0.000 | 0.797 | Pulsar-STXC <5 W [pulsarstx]
Cámara | 0.60 | 0.80 | 0% | 3% | 0.000 | 0.029 | Sensor 0,38 W [mt9p031] + reguladores
Calentador de batería | 0.40 | 0.50 | 15% | 15% | 0.096 | 0.096 | ET-27
Total |  |  |  |  | 1.62 | 3.07
Total con margen |  |  |  |  | 1.95 | 3.68
Balance órbita nominal (Wh) | 0.46
Balance órbita peor caso (Wh) | -1.27
Balance diario con órbitas de peor caso (Wh) | 1.79
Energía de eclipse, peor caso (Wh) | 1.37
Profundidad de descarga peor órbita | 10.9%
Ciclos en 6 meses | 2747.52
Cumple RNF-09 (balance > 0) | Sí
Cumple RNF-10 (DoD ≤ 20 %) | Sí

Sheet: Masa_Volumen
Elemento | Masa (g) | Fuente masa | Altura en Z (mm) | Observación
EPS + batería 2S (P1) | 180 | Tabla 3-4 [soapwr] (2 celdas ≈ 100 g) | 22 | Celda de 18,5 mm + PCB + separación
OBC-ADCS (P2) | 50 | Tabla 8-4 [soaav] | 12 | Componentes bajos
Ruedas (3) con soporte | 140 | Tabla 5-3 [soagnc] |  | En la bahía de carga útil
COM (P3) con blindaje | 195 | TRXVU 75 g [trxvu] + TXS 120 g [txs] | 13
Cámara: lente, filtro, P4 | 120 | Estimación (S-08) | 40 | Bahía de carga útil (incluye ruedas)
Antenas UHF y S | 110 | Tabla 9-2 [soacom] | 5 | Tapa +Z
Estructura, paneles, magnetorquers, arnés | 280 | Estructura 115 g [spacemanic] + resto estimado
Total | 1075 |  | 92
Masa con margen 20 % | 1290
Límites (CDS / S-10) | 2000 |  | 95 | Masa 1U ≤ 2,00 kg [cds]; altura útil 95 mm (S-10)
Margen | 710 |  | 3

Sheet: Datos
Fuente | Datos por adquisición (MB) | Adquisiciones por día (promedio) | Volumen por día (MB) | Almacenamiento 7 días pico (MB) | Tasa / canal
Imagen 4 bandas (comprimida) | 49.1 | 0.57 | 28.1 | 343.901376 | Banda S 1 Mbps
Miniaturas (20 kB × tomas) | 0.52 | 0.57 | 0.30 | 3.6 | UHF o S
Registro ADCS en captura (100 B a 10 Hz, 120 s) | 0.12 | 0.57 | 0.07 | 0.8 | S
Telemetría (200 B cada 60 s) | 0.0002 | 1440 | 0.29 | 2.0 | UHF 9,6 kbps
Total |  |  | 28.7 | 350.397376
Capacidad útil de banda S (MB/día) | 49.1
Uso de la capacidad S (promedio) | 57.93592259%
Días para descargar una sesión | 1.00
Almacenamiento útil especificado (MB) | 1000
Cumple RNF-04 (7 días) | Sí
Cumple RNF-05 (≤ 2 días por sesión) | Sí

Sheet: Enlace
Parámetro | UHF bajada | S bajada | Unidad / fuente
Elevación mínima | 10 | 10 | ° (S-03)
Distancia máxima | 1815.652169 | 1815.652169 | km
Frecuencia | 437.0 | 2245.0 | MHz
Potencia TX | 0.0 | 0.0 | dBW (30 dBm)
Pérdida de línea TX | 1.0 | 1.0 | dB
Ganancia TX | 0.0 | 6.0 | dBi (dipolo / parche, Tabla 9-2)
Atmósfera + polarización | 2.0 | 2.0 | dB
Apuntamiento | 3.0 | 3.0 | dB
G/T del receptor | -10.3 | 4.9 | dB/K (Yagi 16,3 dBi, NF 2 dB / parábola 2 m) [isisgs, ntnugs]
Tasa de datos | 9600.0 | 1000000.0 | bit/s
Eb/N0 requerido (S-13) | 9.6 | 4.1 | dB [murota, ccsds130]
PIRE | -1.0 | 5.0 | dBW
Pérdida de espacio libre | 150.4 | 164.6 | dB
C/N0 | 61.8 | 68.9 | dBHz
Eb/N0 obtenido | 22.0 | 8.9 | dB
Margen | 12.4 | 4.8 | dB
Cumple RNF-06 (≥ 3 dB) | Sí | Sí
Margen con 1 dB de pérdida de implementación | 11.4 | 3.8
S bajada con parábola de 1,2 m (R-05) |  | 0.3
Subida UHF (por sensibilidad) | Valor |  | Unidad / fuente
Potencia TX estación | 120 |  | W [ntnugs]
Pérdida de línea TX | 2 |  | dB
Ganancia Yagi | 16.3 |  | dBi [ntnugs]
Atmósfera + polarización | 2 |  | dB
Apuntamiento | 3 |  | dB
Ganancia antena satélite | 0 |  | dBi
Pérdida de línea RX | 1 |  | dB
Sensibilidad RX (BER 1E-5, FSK 9,6 kbps) | -104 |  | dBm [trxvu]
Potencia recibida | -91.3 |  | dBm
Margen | 12.7 |  | dB

Sheet: Interfaces
ID | Origen | Destino | Función | Señal / protocolo | Características eléctricas prelim. | Tasa / volumen | Observaciones
IF01* | Paneles | P1 | Potencia solar | 4 pares independientes | 2 celdas en serie: V_mp≈4,8 V, I_mp≈0,5 A | DC | Diodo de bloqueo por cara; NTC por panel
IF02 | Batería | P1 | Almacenamiento | Terminales + NTC | 6,0--8,4 V, ≤3 A | DC | Fusible térmico/PTC en la celda
IF03* | P1 | P2, P3, P4, ruedas | Distribución | Conector de apilado | VBAT, 5V_SW (4 salidas), 3V3_SW (4 salidas), GND; ≤2 A por pin | DC | Retornos por pines dedicados; tierra en estrella en P1 [ecss20]
IF04* | P2 | P1 | Telemetría y comandos EPS | I2C-1 + latido + reset (discretas) | 3,3 V, pull-up en P2, 100 kHz | ≈200 B/s | Bus exclusivo EPS; P1 aislado si P2 apagado
IF05* | P2 | P3 (UHF) | TT&C | UART + enable + reset | 3,3 V, 115,2 kbaud | 9,6 kbps | Inhibidor FET en VBAT de radio
IF06* | P2 | P3 (S) | Datos de imagen | SPI + enable + estado | 3,3 V, ≥8 MHz | 1 Mbps | FIFO en transmisor
IF07* | P4 | P2 | Píxeles y configuración | Paralelo 12 b + PIXCLK, HSYNC, VSYNC, XCLK, I2C-2, RESET | Niveles 1,8--3,3 V con traductor de nivel en P4; cable FFC ≤80 mm | 96 MB/s ráfagas | Tierras intercaladas en FFC; igualar longitudes
IF08* | P2 | Bobinas MTQ | Actuación magnética | PWM a puente H | 5 V, ≤120 mA por eje | 10 Hz | Medición de corriente por eje
IF09* | P2, P1 | Ruedas | Actuación fina | UART + 5V_SW | 3,3 V lógica; pico 1,5 W total | 10 Hz | Controlador de velocidad en la rueda
IF10* | Paneles | P2 | Sensores solares, temperatura | Analógico (fotodiodos) | 0--3,3 V, filtrado RC | 10 Hz | Pares trenzados con retorno propio
IF11 | P3 | Antenas | RF | Coaxial 50 Ω | UHF 30 dBm; S 30 dBm | -- | Pérdida ≤1 dB
IF12* | P1 | Antena UHF | Despliegue | Quemador por FET | VBAT, ≈1 A, 5 s | Único | 3 inhibidores; habilitado a los 30 min
IF13* | Interruptores / RBF | P1 | Inhibición | Contactos en serie | Corta VBAT de todas las cargas | -- | Reinicio de temporizadores
IF14* | Umbilical | P1, P2 | Carga, depuración | SWD + UART + carga externa | 3,3 V; carga ≤8,4 V | -- | Por puerto de acceso (RNF-15)

Sheet: Riesgos
ID | Riesgo | Consecuencia | Mitigación / acción pendiente
R-01 | Altura de apilado insuficiente (margen 3 mm). | No cabe el sistema. | Exigir ≥95 mm útiles al seleccionar la estructura (S-10); plan B: integrar COM en P2 (D2-B), que libera 13 mm.
R-02 | Baja oferta de sensores con salida paralela. | Cambio de la interfaz de cámara. | Si el sensor elegido solo ofrece MIPI, añadir un puente MIPI--paralelo en P4; IF07 no cambia hacia P2.
R-03 | Filtro de franjas a medida (costo y plazo). | Retraso de la carga útil. | Cotizar temprano; alternativa: cuatro filtros comerciales cortados y pegados con máscara.
R-04 | Nubosidad sobre la zona cafetera. | Imágenes inútiles, datos desperdiciados. | Miniaturas por UHF para elegir qué descargar; capturas en la mañana (S-01).
R-05 | La estación de Medellín solo dispone de parábola de 1,2 m. | Margen S de 0,3 dB (<3 dB). | Reducir a 512 kbps (margen 3,2 dB) y descargar en dos pases.
R-06 | SEL/SEU en componentes COTS. | Pérdida de funciones o reinicios. | LCL con reconexión, watchdog externo, ECC y doble arranque [soaav].
R-07 | SNR insuficiente en NIR (baja eficiencia cuántica del silicio). | Índices ruidosos. | Banda NIR ancha (ET-01), exposición y ganancia ajustables, y agrupación de píxeles 2×2 (GSD 97 m) si la señal es baja.
R-08 | OBC como punto único de falla. | Pérdida de la misión. | EPS autónoma y supervisora; modo seguro; actualización de software en órbita.
R-09 | Licencias: la banda de aficionados prohíbe cifrado y uso con fines de lucro. | Restricción de operación. | Datos abiertos; trámite ante la ANE y coordinación IARU iniciados al congelar frecuencias [soacom].
