DuvanRamirez/CubeSat_UD34/P2 – OBC-ADCS/Calculos/P2_OBC-ADCS_P4_soporte.xlsx

Sheet: Leeme
CubeSat UD34 – Práctica 4 – PCB P2 OBC-ADCS: hoja de soporte
Consulta de fuentes y precios: Moneda de análisis: USD; tasa EUR→USD editable en la hoja Costos.
Colores: azul = dato de entrada; negro = fórmula; amarillo = supuesto o valor estimado que debe revisarse.

Sheet: Especificaciones
Requisito P3 | ET / interfaz | Función en P2 | Implementación
RF-02/RF-03 | ET-05, ET-06, ET-08 | Captura programada y archivo no volátil | DCMI + DMA a SDRAM; eMMC 4 GB (≥1 GB útil)
RF-05/RF-06 | IF04, IF05 | Telemetría y telecomando | I2C1 a EPS; USART1 a UHF
RF-04 | IF06 | Descarga de imágenes | SPI2 a transmisor S (≥8 MHz)
RF-07 | ET-17 | Determinación de actitud | IMU SPI1, magnetómetro I2C2, 16 canales ADC solares, ≥10 Hz
RF-08 | ET-16, ET-18, IF08, IF09 | Actuación de actitud | 3 puentes H (PWM) + medición de corriente; 3 UART a ruedas
RF-12, RNF-13 | ET-23 | Tiempo a bordo | RTC compensado; error ≤0,5 s en 48 h
RF-13, RNF-14 | ET-24 | Supervisión | Latido a EPS cada ≤10 s; NRST controlado por EPS; IWDG interno
RNF-12 | ET-09, ET-10, ET-11 | Recursos de cómputo | Cortex-M7 ≥400 MHz, SDRAM 32 MB, 2 MB flash doble banco, QSPI NOR
RNF-15 | IF14 | Prueba independiente | SWD local + umbilical (SWD/UART) por el bus
RA-01 | ET-27 | Temperatura | Componentes con rango ≥ −20…+50 °C (preferible −40…+85 °C)
RA-03 | ET-22, ET-24 | SEL/SEU | LCL en P1 por riel; ECC en flash/RAM; doble imagen de arranque
RA-05 | ET-28 | EMC | Plano de tierra continuo; relojes rápidos lejos del bus hacia COM
RN-10 | — | Buenas prácticas | ECSS-Q-ST-70-12C para diseño de PCB

Sheet: Cambios_P3
ID | Decisión P3 afectada | Cambio | Efecto en el sistema
C-01 | TBD-01 (conectores) | Resuelto: apilado PC/104 con 2× Samtec ESQ-126-39-G-D; FFC Hirose FH12 de 40 pines a P4; JST GH de 8 pines a paneles y ruedas. | El resto de tarjetas debe adoptar la asignación de pines de la Tabla de conectores.
C-02 | ET-23 RTC ≤2 ppm | Se adopta RV-3032-C7: ±1,5 ppm (0…50 °C) y ±2,5 ppm (−40…85 °C). | Deriva peor caso 0,43 s en 48 h: sigue cumpliendo RNF-13 (≤0,5 s).
C-03 | OBC 0,90 W máx (Tabla de potencia P3) | Pico calculado de P2: 1,57 W (MCU 400 MHz con todos los periféricos 220 mA, SDRAM 105 mA, eMMC 121 mA, NOR 25 mA, sensores 4 mA; valores de hoja de datos). | Solo en ráfagas de captura/compresión (≈2 min/sesión): +0,02 Wh/órbita de peor caso; el balance diario (+1,8 Wh) no cambia de signo.
C-04 | I2C-2 compartido con la cámara (IF07) | La configuración de la cámara pasa a I2C3 dedicado. | Una falla en el cable de la cámara no bloquea magnetómetro ni RTC.
C-05 | Magnetómetro (clase MEMS) | LIS2MDL en lugar de LIS3MDL. | LIS3MDL está NRND en ST y obsoleto en DigiKey.
C-06 | Reloj lento del MCU | El RTC externo entrega 32,768 kHz compensado al LSE del MCU (modo bypass). | Se elimina el cristal de 32 kHz y la base de tiempo del MCU hereda la compensación.
C-07 | Magnetómetro en SPI junto con la IMU (diagrama de P2, P3) | El magnetómetro LIS2MDL pasa a I2C2, compartido con el RTC; la IMU conserva su SPI1 dedicado. | El LIS2MDL se comunica por I2C a 400 kHz, suficiente para 10 Hz (ET-17); SPI1 queda solo para la IMU, que necesita mayor tasa. No cambia ningún requisito.
C-08 | eMMC ASFC4G31M-51BIN (selección inicial de la P4) | Se usa ASFC4G31MA-51BIN, misma familia, capacidad, tensiones y encapsulado. | El M-51BIN está obsoleto (LTB 2025-06-03) y sin stock. El MA sube el costo de la eMMC a 39–41 USD y su Tabla 4 da 121 mA en el modo usado (C-03). Octopart también lo marca obsoleto (LTB 2026-06-30): comprar el lote pronto o buscar reemplazo.
C-09 | Cristal HSE ABM8-25.000MHZ-D2Y-T (CL 18 pF) elegido en la P4 | Se usa ECS-250-8-33-JGN-TR (25 MHz, CL 8 pF, ESR 40 Ω, C0 5 pF, −40…85 °C) con condensadores de 6,8 pF. | Con el ABM8, gmcrit = 3,08 mA/V supera el Gm_crit_max de 1,5 mA/V del STM32H743 (DS12110 Tabla 34; AN2867 §3.4): el arranque no estaba garantizado. Con el ECS, gmcrit = 0,67 mA/V. Costo similar (0,29–0,45 USD).
C-10 | eMMC ASFC4G31MA-51BIN (C-08) | Se usa ISSI IS21EF04GP-JCLI (eMMC 5.1, 4 GB pSLC, −40…85 °C, VCC/VCCQ 2,7–3,6 V, 153 FBGA 11,5×13 mm con el mapa de bolas JEDEC). C10 (VDDi) = 1 µF. | Octopart marca el ASFC4G31MA obsoleto (LTB 2026-06-30, LTD 2026-12-30). El ISSI está activo (Arrow; Suntsu 1.333 u el 2026-10-24) y su hoja sí da el condensador de VDDi (≥0,1 µF, 1 µF recomendado; Tabla 8.3 CREG 1 µF mín.). Consumo 120 mA (SDR52). Precio sin publicar: se cotiza por RFQ.
C-12 | eMMC IS21EF04GP-JCLI (153 bolas) y J9 FTSH-105-01-F-DV | IS21EF04GP-JQLI (misma memoria, 100-LFBGA 14×18) y FTSH-105-01-L-DV-K (polarizado, pin 7 = KEY) | Son los modelos de la librería de Altium que usa el equipo. Misma hoja de datos y mismo circuito; la JQLI está activa (Suntsu 312 u). El J9 polarizado evita conectar el depurador al revés.
C-11 | Pasivos «por definir en Altium» y precio estimado | Referencia exacta de cada resistencia, condensador, shunt y ferrita (hoja BOM), con dieléctrico X7R/C0G y tensión ≥2× la de trabajo | Cantidades exactas desde el esquemático de referencia (58 × 100 nF, 16 × 1 kΩ…); costo con precios por escala de LCSC/Future; ciclo de vida verificado

Sheet: Seleccion
Función | Especificación | Elegido | Alternativas | Justificación | Fuente (sección)
MCU | ET-10/11, ET-07, RNF-12 | STM32H743IIT6 (LQFP176) | STM32H743ZIT6 (LQFP144); STM32H753 (crypto) | Único encapsulado no-BGA con FMC-SDRAM 16 bits + DCMI 12 bits + SDMMC + QUADSPI simultáneos y ≥20 canales ADC; 1,62–3,6 V, −40…85 °C; 2 MB flash doble banco para dos imágenes. LQFP144 deja pocos pines para ADC tras FMC y DCMI. | DS12110 §1 (características), §3.15 FMC, §3.16 QUADSPI, §3.24 DCMI; ficha DigiKey 497-17722-ND
SDRAM | ET-09 | ISSI IS42S16160L-6TLI (256 Mb ×16) | IS42S16160J-6TLI (no stock); Alliance AS4C16M16SA | 32 MB a 3,3 V, 166 MHz (margen sobre FMC ≤100 MHz), −40…85 °C, TSOP-II (sin BGA). La versión J está en ‘available but not stocked’. | Ficha ISSI/Avnet 256Mb SDRAM (refresco 8K/64 ms); DigiKey 706-IS42S16160L-6TLI-ND
Almacenamiento | ET-08, RNF-04 | ISSI IS21EF04GP-JQLI (eMMC 5.1, 4 GB pSLC) | Kingston EMMC04G-WT32-01G10; SD-NAND LGA-8 | eMMC 5.1 industrial −40…85 °C, NAND pSLC (más ciclos de escritura que MLC); VCC 2,7–3,6 V y VCCQ 2,7–3,6 V (3,3 V como el MCU); 153 FBGA 11,5×13×1,0 mm con el mapa JEDEC. Reemplaza al ASFC4G31MA-51BIN, obsoleto (C-10). Activo (Arrow, Suntsu: 1.333 u, 2026-10-24). | ISSI IS21/22EF04GP/08GP datasheet Rev. A2 (30-05-2024): §1.2 Tabla 1.1 (p. 7), §2 mapa de bolas (p. 14), §3 pines (p. 16), Tabla 8.1 tensiones, Tabla 8.3 (p. 41), §9.2 paquete (p. 52); Arrow y Suntsu (2026-10-24/25)
Memoria de arranque | ET-11, RNF-14 | Winbond W25Q128JVSIQ (QSPI NOR 128 Mb) | Micron MT25QL128; MRAM SPI | Imagen de respaldo y parámetros; 133 MHz QSPI, −40…85 °C, SOIC-8 208 mil fácil de inspeccionar; alto stock. | Hoja de datos W25Q128JV; DigiKey W25Q128JVSIQ-ND
IMU | ET-17 | ST ISM330DHCXTR | ST LSM6DSO; Bosch BMI088 | Grado industrial −40…105 °C con compensación de temperatura; SPI dedicado; ±125 °/s seleccionable para resolución fina. | Página de producto ST ISM330DHCX; DigiKey 497-19784-1-ND
Magnetómetro | ET-17 | ST LIS2MDLTR | ST LIS3MDL (NRND); PNI RM3100 (módulo grande) | Activo, 1,71–3,6 V, −40…85 °C, LGA-12 2×2 mm; ±50 G cubre el campo terrestre (~0,3 G) con margen ante campos internos. | Página ST LIS2MDL; Newark 07AH6648
RTC | ET-23, RNF-13 | Micro Crystal RV-3032-C7 (2,5 ppm) | Maxim DS3231M; RV-3028-C7 (1 ppm a 25 °C, sin compensación) | Compensado de fábrica: ±1,5 ppm (0…50 °C), ±2,5 ppm (−40…85 °C); 160 nA; CLKOUT 32,768 kHz para el LSE del MCU. | Página Micro Crystal RV-3032-C7; DigiKey 2195-RV-3032-C7…
Puente H MTQ | IF08, ET-18 | TI DRV8837DSGR ×3 | TI DRV8833 (doble); DRV8212 | VM 0–11 V (5 V nominal) y 1,8 A frente a ≤0,12 A por eje; lógica 1,8–7 V; nSLEEP permite apagar las bobinas en reposo. | Hoja de datos TI DRV8837; Mouser 595-DRV8837DSGR
Medición de corriente MTQ | IF08 | TI INA180A2IDBVR ×3 | INA219 (I2C); shunt + ADC directo | Ganancia fija 50 V/V ±1 %, modo común −0,2…26 V (lado alto en 5 V), salida analógica al ADC del MCU. | Página TI INA180; DigiKey 296-47653-1-ND
Conector de apilado | TBD-01, IF03–IF06, IF14 | Samtec ESQ-126-39-G-D ×2 | Samtec ESQ-126-37; conector propietario de la estructura | Estándar PC/104 usado por estructuras 1U; 5,7 A por contacto (dato distribuidor); −55…125 °C. | Master Electronics / Electro Sonic ESQ-126-39-G-D
Conector cámara | IF07 | Hirose FH12-40S-0.5SH(55) | TE / Amphenol FFC 0,5 mm | 40 posiciones permiten intercalar 15 tierras con 21 señales; 0,5 A/contacto; −40…85 °C. | Farnell 1324556
Conectores paneles y ruedas | IF08–IF10 | JST SM08B-GHS-TB ×5 | Molex PicoBlade | Cierre por rampa (vibración), 1 A, 50 V; −25…85 °C cubre el rango interno −20…+50 °C. | RS 175-5600

Sheet: Conectores
J1 – Samtec ESQ-126-39-G-D (H1, señales; pines no listados: paso sin conexión)
Pin | Red | Interfaz P3
1 | I2C1_SCL | IF04
2 | GND
3 | I2C1_SDA | IF04
4 | GND
5 | OBC_HB | IF04 (latido OBC→EPS)
6 | OBC_RST_N | IF04 (EPS→NRST, colector abierto)
7 | UHF_TXD | IF05 (OBC→UHF)
8 | UHF_RXD | IF05
9 | UHF_EN | IF05
10 | UHF_RST_N | IF05
11 | GND
12 | GND
13 | S_SCK | IF06
14 | S_MOSI | IF06
15 | S_MISO | IF06
16 | S_CS_N | IF06
17 | S_EN | IF06
18 | S_STATUS | IF06
19 | GND
20 | GND
21 | UMB_SWDIO | IF14
22 | UMB_SWCLK | IF14
23 | UMB_NRST | IF14
24 | UMB_TXD | IF14 (UART5)
25 | UMB_RXD | IF14
26 | GND
J2 – Samtec ESQ-126-39-G-D (H2, potencia; pines no listados: paso sin conexión)
Pin | Red | Interfaz P3
1 | 3V3_SW_OBC | IF03
2 | 3V3_SW_OBC | IF03
3 | 3V3_SW_OBC | IF03
4 | GND
5 | GND
6 | GND
7 | 3V3_SW_CAM | IF03 (paso a P4)
8 | 3V3_SW_CAM | IF03
9 | GND
10 | GND
11 | 5V_SW_ADCS | IF03 (MTQ + ruedas)
12 | 5V_SW_ADCS | IF03
13 | GND
14 | GND
15 | VBAT | solo paso (no se usa en P2)
16 | VBAT | solo paso
17 | GND
J3 – Hirose FH12-40S-0.5SH(55) (FFC a P4, IF07)
Pin | Red
1 | GND
2 | DCMI_D0
3 | DCMI_D1
4 | GND
5 | DCMI_D2
6 | DCMI_D3
7 | GND
8 | DCMI_D4
9 | DCMI_D5
10 | GND
11 | DCMI_D6
12 | DCMI_D7
13 | GND
14 | DCMI_D8
15 | DCMI_D9
16 | GND
17 | DCMI_D10
18 | DCMI_D11
19 | GND
20 | DCMI_PIXCLK
21 | GND
22 | DCMI_HSYNC
23 | DCMI_VSYNC
24 | GND
25 | CAM_XCLK
26 | GND
27 | I2C3_SCL
28 | I2C3_SDA
29 | CAM_RST_N
30 | CAM_STBY
31 | CAM_TRIG
32 | GND
33 | 3V3_SW_CAM
34 | 3V3_SW_CAM
35 | 3V3_SW_CAM
36 | GND
37 | GND
38 | CAM_NTC
39 | GND
40 | GND
J4 (+X), J5 (+Y), J6 (−X), J7 (−Y) – JST SM08B-GHS-TB (paneles; n = cara). MTQ: X en J4, Y en J5, Z en J6; J7 pines 6–7 NC
Pin | Red
1 | SUNn_A
2 | SUNn_B
3 | SUNn_C
4 | SUNn_D
5 | GND (retorno fotodiodos)
6 | MTQn_A
7 | MTQn_B
8 | GND
J8 – JST SM08B-GHS-TB (ruedas, IF09)
Pin | Red
1 | RW1_TXD
2 | RW1_RXD
3 | RW2_TXD
4 | RW2_RXD
5 | RW3_TXD
6 | RW3_RXD
7 | 5V_SW_ADCS
8 | GND
J9 – Samtec FTSH-105-01-F-DV (SWD, Cortex 10 pines)
Pin | Red
1 | VTREF (3V3)
2 | SWDIO
3 | GND
4 | SWCLK
5 | GND
6 | SWO
7 | NC (llave)
8 | NC
9 | GND
10 | NRST

Sheet: Calculos
Cálculo | Parámetro | Valor | Unidad | Fuente / fórmula
Consumo 3V3 máx | MCU 400 MHz, todos los periféricos | 220 | mA | Emcraft STM32H7 SOM (según hoja de datos STM32H75xB)
Consumo 3V3 máx | SDRAM auto-refresco (Idd5, grado -6) | 105 | mA | IS42S16160L Rev. A, DC Electrical Characteristics 1, p. 18: Idd5 = 105 mA (máx. de la tabla)
Consumo 3V3 máx | eMMC lectura SDR52 (ICC + ICCQ) | 120 | mA | IS21/22EF04GP (misma tabla para JCLI y JQLI) Rev. A2 (30-05-2024), Tabla 1.1, §1.2, p. 7: SDR52 lectura 20 mA ICC + 100 mA ICCQ (escritura 4 GB: 40 + 70 = 110 mA); modo usado: SDR 4 bits ≤50 MHz
Consumo 3V3 máx | NOR QSPI programa/borrado (peor caso) | 25 | mA | W25Q128JV Rev J, §9.4 DC Electrical Characteristics: ICC4–ICC7 = 25 mA máx
Consumo 3V3 máx | IMU + MAG + RTC + 3×INA180 + pull-ups | 4 | mA | INA180 0,26 mA máx c/u (TI); resto <1 mA (estimado)
Consumo 3V3 máx | Total P2 | 474.000 | mA | Suma
Consumo 3V3 máx | Potencia P2 máxima | 1.564 | W | P = V·I
Consumo nominal | Potencia P2 nominal (P3) | 0.350 | W | P3 Tabla de potencia (clase Tabla 8-4 SoA)
Paso de corriente | 3V3_SW_CAM a P4 | 242.424 | mA | P3: cámara 0,80 W máx
Paso de corriente | 5V_SW_ADCS (MTQ + ruedas) | 520.000 | mA | P3: MTQ 1,47 W, ruedas 1,13 W
Paso de corriente | 3V3 total por el conector | 716.424 | mA
Ancho de pista (IPC-2221) | Elevación de temperatura admitida | 10 | °C | Supuesto conservador (vacío: sin convección)
Ancho de pista (IPC-2221) | Espesor de cobre 1 oz | 1.378 | mil | 1 oz = 35 µm
Ancho de pista (IPC-2221) | Ancho mínimo externo para 3V3 total | 0.190 | mm | A=(I/(k·ΔT^0.44))^(1/0.725), k=0,048 externo
Ancho de pista (IPC-2221) | Ancho mínimo interno para 3V3 total | 0.493 | mm | k=0,024 interno
Ancho de pista (IPC-2221) | Ancho mínimo externo para 5V_ADCS | 0.122 | mm
Caída de tensión | Longitud de un tramo de distribución | 60 | mm | Supuesto (tarjeta de ~90 mm)
Caída de tensión | Ancho de trazo evaluado | 0.500 | mm | PCB-01
Caída de tensión | Caída en 3V3 con ese trazo | 42.249 | mV | ΔV = ρ·L/(w·t)·I; ρCu = 1,72e-8 Ω·m
Caída de tensión | ¿Cumple ≤30 mV con trazo? | No → usar plano L3 |  | PCB-01
HSE | Capacidad de carga del cristal CL | 8 | pF | ECS-250-8-33-JGN-TR (ECX-32): CL = 8 pF
HSE | Capacidad parásita estimada | 5 | pF | AN2867: típico 2–5 pF (se toma el máximo)
HSE | Condensador de carga calculado | 6.000 | pF | AN2867: CL = C1·C2/(C1+C2) + Cs → C1=C2=2(CL−Cs)
HSE | Valor normalizado | 6.800 | pF | Serie E12: 6,8 pF (CL efectiva 8,4 pF con Cs = 5 pF)
Pull-up I2C1 | Capacidad del bus estimada | 100 | pF | Estimado (conector/FFC + entradas)
Pull-up I2C1 | Tiempo de subida máx 100 kHz (EPS por el bus) | 1000 | ns | UM10204
Pull-up I2C1 | Rp máxima | 11802.195 | Ω | Rp(max)=tr/(0,8473·Cb) (UM10204)
Pull-up I2C1 | Rp mínima | 966.667 | Ω | Rp(min)=(VDD−VOL)/IOL, 3 mA (UM10204)
Pull-up I2C1 | Rp elegida | 4700 | Ω | Entre mínimo y máximo
Pull-up I2C1 | ¿Dentro de rango? | Sí
Pull-up I2C2 | Capacidad del bus estimada | 50 | pF | Estimado (conector/FFC + entradas)
Pull-up I2C2 | Tiempo de subida máx 400 kHz (local) | 300 | ns | UM10204
Pull-up I2C2 | Rp máxima | 7081.317 | Ω | Rp(max)=tr/(0,8473·Cb) (UM10204)
Pull-up I2C2 | Rp mínima | 966.667 | Ω | Rp(min)=(VDD−VOL)/IOL, 3 mA (UM10204)
Pull-up I2C2 | Rp elegida | 2200 | Ω | Entre mínimo y máximo
Pull-up I2C2 | ¿Dentro de rango? | Sí
Pull-up I2C3 | Capacidad del bus estimada | 60 | pF | Estimado (conector/FFC + entradas)
Pull-up I2C3 | Tiempo de subida máx 100 kHz (FFC a P4) | 1000 | ns | UM10204
Pull-up I2C3 | Rp máxima | 19670.325 | Ω | Rp(max)=tr/(0,8473·Cb) (UM10204)
Pull-up I2C3 | Rp mínima | 966.667 | Ω | Rp(min)=(VDD−VOL)/IOL, 3 mA (UM10204)
Pull-up I2C3 | Rp elegida | 4700 | Ω | Entre mínimo y máximo
Pull-up I2C3 | ¿Dentro de rango? | Sí
Medición MTQ | Corriente máxima por eje | 120 | mA | IF08
Medición MTQ | Shunt | 0.470 | Ω | Elegido
Medición MTQ | Salida INA180A2 a Imax | 2.820 | V | Vout = G·Rsh·I, G = 50 V/V
Medición MTQ | Disipación en el shunt | 6.768 | mW | P = R·I²
Medición MTQ | Caída en el shunt | 56.400 | mV
Medición MTQ | Resistencia mínima de bobina (dato para P1/paneles) | 41.667 | Ω | R ≥ V/Imax
Filtro solar | R serie | 1000 | Ω | Elegido
Filtro solar | C a GND | 100 | nF | Elegido
Filtro solar | Frecuencia de corte | 1591.549 | Hz | fc = 1/(2πRC); muestreo 10 Hz
SDRAM | Reloj SDCLK | 100 | MHz | FMC ≤100 MHz síncrono (página ST STM32H743)
SDRAM | Filas a refrescar | 8192 |  | IS42S16160 (8K/64 ms)
SDRAM | Periodo de refresco | 64 | ms | IS42S16160 industrial
SDRAM | Registro FMC_SDRTR COUNT | 761.000 | ciclos | COUNT = (Tref/filas)·fSDCLK − 20 (RM0433)
SDRAM | Ancho de banda pico | 200.000 | MB/s | 16 bits × fSDCLK
DCMI | Flujo de la cámara a SDRAM | 96.000 | MB/s | 48 MHz × 2 bytes/píxel (ET-07)
DCMI | ¿SDRAM soporta la captura? | Sí (margen ≥1,5)
Integridad de señal | εr prepreg 7628 | 4.400 |  | JLCPCB
Integridad de señal | εr efectiva microstrip (w/h≈1,7) | 3.299 |  | Hammerstad
Integridad de señal | Retardo por mm | 6.058 | ps/mm | tpd = √εeff / c
Integridad de señal | Desajuste de longitud permitido | 10 | mm | PCB-09, PCB-11
Integridad de señal | Sesgo resultante | 60.583 | ps
Integridad de señal | Fracción del periodo a 100 MHz | 0.006
Impedancia | Altura dieléctrica L1–L2 | 0.210 | mm | Pila estándar 4 capas (prepreg 7628), a confirmar
Impedancia | Ancho de pista | 0.350 | mm | Elegido
Impedancia | Z0 microstrip | 49.985 | Ω | IPC-2141 (preliminar)
Magnetómetro | Distancia a corrientes MTQ | 50 | mm | PCB-16
Magnetómetro | Campo parásito de 0,12 A | 0.480 | µT | B = µ0·I/(2πr)
Magnetómetro | Fracción del campo terrestre (30 µT) | 0.016
RTC | Precisión peor caso | 2.500 | ppm | RV-3032-C7 (−40…85 °C)
RTC | Deriva en 48 h | 0.432 | s | Debe ser ≤0,5 s (RNF-13)
HSE: arranque | ESR máx. del cristal | 40 | Ω | ECX-32: 24–54 MHz → 40 Ω máx
HSE: arranque | Capacidad paralelo C0 | 5 | pF | ECX-32 (C0 = 5 pF)
HSE: arranque | Frecuencia | 25 | MHz | HSE
HSE: arranque | gmcrit = 4·ESR·(2πF)²·(C0+CL)² | 0.6671852575 | mA/V | AN2867 Rev 24, §3.4, p. 13
HSE: arranque | Gm_crit_max del STM32H743 | 1.5 | mA/V | DS12110 Rev 11, Tabla 34, p. 125
HSE: arranque | Relación Gm_crit_max / gmcrit | 2.248251116 |  | Debe ser > 1 (AN2867)
HSE: arranque | ¿Arranque garantizado? | Sí
HSE: arranque | gmcrit con el ABM8 anterior (CL 18 pF, ESR 50 Ω, C0 7 pF) | 3.084251375 | mA/V | ABM8 (rev. 08.19.15): supera 1,5 mA/V → se descarta (C-09)
NRST | Pull-up interno RPU mínimo | 30 | kΩ | DS12110 Rev 11, Tabla 55 (p. 144): RPU 30–50 kΩ
NRST | Condensador externo | 100 | nF | DS12110 Fig. 23 (p. 144): 0,1 µF recomendado
NRST | Constante de tiempo mínima τ = RPU·C | 3 | ms | Filtra pulsos de ruido; la EPS (OBC_RST_N) y el umbilical lo bajan con colector abierto
VDDA | Consumo de un ADC (16 bits, 25 MHz, single-ended) | 0.72 | mA | DS12110 Rev 11, Tabla 174 (p. 275): IDDA_SE 720 µA
VDDA | ADC en uso | 2 |  | ADC1 y ADC3 (Perifericos_MCU)
VDDA | DCR de la ferrita BLM15AG601SN1D | 0.52 | Ω | Murata BLM15AG601SN1D: 0,52 Ω, 300 mA. AN4938 §2.2: «VDDA can be connected to VDD through a ferrite bead»
VDDA | Caída DC en la ferrita | 0.7488 | mV | Despreciable frente a 3,3 V
VDDA | Uso de la corriente nominal de la ferrita | 0.0048 | — | <1 % de 300 mA
VREF+ | R serie | 47 | Ω | AN4938 Rev 7 §2.2: «VREF+ can be connected to VDDA through a resistor (typically 47 Ω)», con 100 nF + 1 µF en el pin
VREF+ | C a GND | 1 | µF
VREF+ | Frecuencia de corte | 3386.275385 | Hz | Filtra el ruido digital del riel; la tensión DC la corrige el firmware con VREFINT
EMMC_CK | Impedancia objetivo de la pista | 50 | Ω | PCB-10 / hoja Calculos (Z0 microstrip)
EMMC_CK | Impedancia de salida estimada del pin | 28 | Ω | Inferencia: pin GPIO en velocidad alta (no tabulada en DS12110)
EMMC_CK | R serie de terminación = Z0 − Rsalida | 22 | Ω | Se normaliza a 22 Ω (E12); terminación en fuente, junto al MCU
Pull-ups 10 kΩ | Corriente con la línea en 0 | 0.33 | mA | EMMC_CMD, EMMC_D0–D3 (Tabla 8.3 de la eMMC: 4,7–50 kΩ CMD, 10–50 kΩ DAT), IMU_CS_N, QSPI_NCS, RTC_INT, BOOT0
Pull-ups 10 kΩ | Potencia en la resistencia | 1.089 | mW | Frente a 62,5 mW nominales (0402)
Pull-downs 100 kΩ | Corriente con la salida en 1 | 33 | µA | MTQ_nSLEEP, UHF_EN, S_EN, CAM_RST_N: mantienen apagado/en reset mientras el MCU arranca (GPIO en alta impedancia)
Shunt MTQ | Potencia nominal RL0603 | 100 | mW | YAGEO RL0603FR-070R47L
Shunt MTQ | Uso de la potencia nominal | 0.06768 | — | 6,8 mW calculados arriba (fila 47)
Condensadores | Tensión de trabajo máx. 3V3 / nominal 16 V | 0.20625 | — | Regla adoptada: tensión nominal ≥2× la de trabajo (pérdida por polarización DC en X7R)
Condensadores | Tensión de trabajo 5 V / nominal 16 V (10 µF de 5V_SW_ADCS y 100 nF de VM) | 0.3125 | — | Cumple 2×; el 10 µF de 25 V X7R 0805 no tiene stock (52 semanas): se usa el de 16 V
Condensadores | VCAP (núcleo ~1,2 V) / nominal 10 V | 0.12 | — | AN4938 §2.2: 2,2 µF cerámico, ESR <100 mΩ
Condensadores | Dieléctrico | X7R / C0G |  | X7R: −55…125 °C (X5R solo hasta 85 °C, límite del rango −40…85 °C de la tarjeta). C0G en los 6,8 pF del cristal por estabilidad (AN2867)

Sheet: Restricciones
ID | Trazabilidad | Restricción y alcance | Tipo de fuente | Fuente y fundamento | Aplicación (dónde queda registrada) | Verificación / estado
PCB-01 | ET-21, IF03 | 3V3_SW_OBC: hasta 0,48 A (P2) + 0,24 A de paso a P4 = 0,72 A. Distribución por plano en L3; tramos en trazo ≥0,5 mm (IPC-2221 pide 0,49 mm en capa interna y 0,19 mm en externa con ΔT = 10 °C); caída total ≤30 mV (1 %). | Inferencia propia | Cálculo IPC-2221 + resistencia del cobre (hoja Calculos, filas Ancho/caída). | Directiva: clase PWR_3V3 + regla Width (mín 0,5 / pref 1,0 mm). | Revisión de reglas en PCB (guía siguiente). Estado: directiva definida.
PCB-02 | IF03, IF08, IF09 | 5V_SW_ADCS: 0,52 A pico (MTQ 0,29 A + ruedas 0,23 A). Trazo ≥0,5 mm o polígono; caída ≤50 mV. | Inferencia propia | Cálculo IPC-2221; Tablas 5-3/5-4 de P3 para las cargas. | Directiva: clase PWR_5V + regla Width. | Estado: directiva definida.
PCB-03 | RA-05, ET-28 | GND: plano continuo en L2 sin cortes bajo SDRAM, DCMI, SDMMC, QSPI ni HSE. | Recomendación adoptada | AN4938 (diseño de hardware STM32H7); ECSS-E-ST-20-07C. | Nota en esquemático (hoja TOP) + regla de plano en PCB. | Pendiente: inspección visual del plano en PCB.
PCB-04 | ET-10 | Desacoplamiento VDD: 100 nF por pin VDD a ≤2 mm del pin y 4,7 µF de bulto en el paquete; vía a GND junto al pad. | Exigida por fuente (valores); distancia = recomendación | AN4938 (tabla de alimentación STM32H7). | Nota junto a cada grupo de condensadores (MCU_CORE). | Pendiente: revisión de ubicación.
PCB-05 | ET-10 | VCAP1 (pin 81) y VCAP2 (pin 125) unidos entre sí (red VCAP), cada uno con 2,2 µF cerámico ESR <100 mΩ junto a su pin (el LQFP176 no tiene VCAP3). | Exigida por fuente | AN4938 Rev 7, §2.2, p. 12: «Connect VCAP1 pin to VCAP2 pin»; DS12110 Rev 11. | Nota en MCU_CORE + clase VCAP (Width ≥0,3 mm). | Estado: definido.
PCB-06 | ET-17 | VDDA: ferrita desde VDD + 1 µF + 100 nF; VREF+: 47 Ω desde VDDA + 1 µF + 100 nF, junto a los pines. | Exigida por fuente | AN4938. | Nota en MCU_CORE. | Estado: definido.
PCB-07 | ET-10 | HSE 25 MHz (ECS-250-8-33-JGN-TR, CL 8 pF): Y1 y C de 6,8 pF a ≤5 mm de OSC_IN/OSC_OUT; anillo de GND; sin señales bajo el cristal en L1/L2. | Recomendación adoptada | AN2867 Rev 24 (§3.4 y recomendaciones de PCB); gmcrit 0,67 mA/V < 1,5 mA/V (DS12110 Tabla 34). | Nota + Room/Keepout en PCB. | Pendiente en PCB.
PCB-08 | ET-09 | Bus SDRAM: impedancia objetivo 50 Ω ±10 % sobre GND (L1/L4 con referencia L2/L3). | Inferencia propia | Ancho preliminar 0,35 mm en L1 sobre prepreg 0,21 mm (εr 4,4), fórmula IPC-2141; confirmar con calculadora del fabricante. | Directiva: clase SDRAM + regla Width (0,35 mm) / Impedance si la versión lo admite. | Pendiente: apilamiento definitivo (guía siguiente).
PCB-09 | ET-09 | Bus SDRAM: diferencia de longitud dentro de cada grupo (datos, dirección/control) respecto a SDCLK ≤10 mm. | Inferencia propia | 10 mm ≈ 66 ps = 0,7 % del periodo de 10 ns a 100 MHz (hoja Calculos). | Directiva: regla Matched Lengths (tolerancia 10 mm) en clase SDRAM. | Estado: directiva definida.
PCB-10 | ET-09 | U2 a ≤30 mm de U1; sin vías innecesarias (≤2 por red). | Inferencia propia | Retardo total <0,3 ns frente a margen de temporización a 100 MHz. | Nota + Room SDRAM en PCB. | Pendiente en PCB.
PCB-11 | IF07, ET-07 | DCMI: J3 junto al MCU; recorrido en P2 ≤50 mm; diferencia de longitud datos–PIXCLK ≤10 mm; resistencia serie 33 Ω en origen (P4). | Inferencia propia | Periodo 20,8 ns a 48 MHz; FFC ≤80 mm (IF07). | Directiva: clase DCMI + Matched Lengths. | Estado: directiva definida.
PCB-12 | ET-08 | SDMMC1: resistencia serie 22 Ω en CK junto al MCU; pull-up de 10 kΩ en CMD y D0–D3; diferencia de longitud ≤5 mm. | Exigida por fuente (rango de pull-up); valor adoptado | IS21/22EF04GP Rev. A2, Tabla 8.3 (p. 41): RCMD 4,7–50 kΩ, RDAT 10–50 kΩ, carga de bus <20 pF; 22 Ω serie: práctica común. | Directiva: clase SDMMC + Matched Lengths (5 mm). | Estado: definido (pull-ups de 10 kΩ dentro del rango).
PCB-13 | ET-11 | QSPI: U4 a ≤30 mm; resistencia serie 22 Ω en CLK. | Inferencia propia | Reflexiones a ≤80 MHz. | Directiva: clase QSPI. | Estado: definido.
PCB-14 | ET-08 | eMMC 100-LFBGA 14×18 mm (IS21EF04GP-JQLI): pads, paso y escape según el dibujo del paquete (hoja ISSI Rev. A2 §9.1, p. 51) y la huella del modelo de Altium; si el paso es ≤0,8 mm, vía en pad rellena y tapada; acabado ENIG. | Exigida por fuente (fabricante) | Hoja ISSI IS21/22EF04GP Rev. A2 §9.1 (paquete de 100 bolas); JLCPCB: pad BGA 0,2–0,25 mm requiere ENIG. | Regla pendiente en PCB (Fanout Control, Width local 0,09 mm) + condición de pedido. | Servicio especial: ENIG + via-in-pad.
PCB-15 | ET-10 | LQFP176 paso 0,5 mm: separación pad-pad ≥0,15 mm y puente de máscara ≥0,10 mm. | Exigida por fuente (fabricante) | JLCPCB: SMD pad-pad 0,15 mm; puente 0,10 mm (verde). | Regla pendiente (Clearance SMD). | Compatible.
PCB-16 | ET-17 | Magnetómetro U6 a ≥50 mm de los DRV8837, shunts y recorridos de 5V_SW_ADCS; sin piezas ferromagnéticas a ≤10 mm. | Inferencia propia | B = µ0·I/(2πr): 0,12 A a 50 mm → 0,48 µT (1,6 % de 30 µT) (hoja Calculos). | Nota en ADCS_SENS + Room en PCB. | Pendiente en PCB.
PCB-17 | IF08 | Bobinas MTQ: ida y retorno de cada bobina en pistas adyacentes (lazo mínimo), ancho ≥0,25 mm. | Inferencia propia | 0,12 A; un lazo grande crea momento magnético parásito. | Directiva: clase MTQ + Width. | Estado: definido.
PCB-18 | ET-17 | Entradas solares: RC (1 kΩ/100 nF) junto al pin ADC; pistas lejos (≥3× ancho) de SDCLK, PIXCLK, QSPI CLK y de los puentes H. | Inferencia propia | fc = 1,59 kHz frente a muestreo de 10 Hz. | Directiva: clase SUN_AN + Clearance 0,3 mm. | Estado: definido.
PCB-19 | IF08 | DRV8837: pad térmico soldado a GND con vías. | Exigida por fuente | Hoja de datos TI DRV8837 (layout). | Nota en MTQ_DRV. | Pendiente en PCB.
PCB-20 | IF03–IF06, TBD-01 | J1/J2 en la posición PC/104 de la estructura elegida; misma asignación en todas las tarjetas. | Exigida por fuente | Plano de interfaz de la estructura (a obtener del proveedor). | Nota en TOP. | Pendiente: plano de la estructura.
PCB-21 | IF03 | Cada riel por ≥2 contactos del bus; GND en ≥8 contactos. | Recomendación adoptada | 5,7 A/contacto (dato distribuidor) frente a ≤0,72 A; redundancia. | Asignación de pines (Tabla de conectores). | Cumple.
PCB-22 | IF07 | J3: 3 contactos para 3V3_SW_CAM (0,24 A) y 15 tierras intercaladas; FFC ≤80 mm. | Exigida por fuente (0,5 A/contacto) + inferencia | Farnell/Hirose FH12; IF07. | Asignación de pines J3. | Cumple.
PCB-23 | R-01 | Altura máxima de componentes y separación entre tarjetas según el conector ESQ-126-39 y la estructura; P3 asignó 12 mm a P2. | Exigida por fuente | Hoja de datos Samtec ESQ (altura de apilado del sufijo -39). | Nota en TOP. | Pendiente: verificar compatibilidad con 12 mm (riesgo R-01).
PCB-24 | RA-02 | MCU (≤0,73 W) sin convección: polígonos GND en L1/L4 conectados por vías al plano y a los agujeros de montaje. | Inferencia propia | Conducción a la estructura como única vía térmica (P3, RA-02). | Nota + regla de polígonos en PCB. | Pendiente en PCB.
PCB-25 | Fabricación | Pista/espacio general ≥0,10/0,10 mm; 0,09 mm solo en escape BGA. | Exigida por fuente (fabricante) + margen adoptado | JLCPCB multicapa 1 oz: 0,09/0,09 mm mín. | Regla Width/Clearance por defecto. | Compatible.
PCB-26 | Fabricación | Vía estándar 0,30/0,50 mm (taladro/pad); vía de escape BGA 0,20/0,40 mm. | Exigida por fuente (fabricante) | JLCPCB: taladro preferido ≥0,2 mm; pad ≥ taladro + 0,1 mm. | Regla Routing Via Style. | Compatible (0,2 mm con diámetro <0,45 mm tiene costo extra).
PCB-27 | Fabricación | Anillo anular PTH ≥0,20 mm; cobre a borde ruteado ≥0,5 mm (fabricante pide ≥0,2 mm). | Exigida por fuente + margen adoptado | JLCPCB: anillo PTH multicapa rec. 0,20 mm; borde ≥0,2 mm. | Reglas en PCB. | Compatible.
PCB-28 | Fabricación | Serigrafía ≥1,0 mm de alto y 0,15 mm de trazo; ≥0,15 mm a pads. | Exigida por fuente | JLCPCB (legend). | Regla Silk to Solder Mask. | Compatible.
PCB-29 | Fabricación | Apilamiento 4 capas, 1,6 mm, cobre externo 1 oz, interno 1 oz, FR-4, ENIG; impedancia controlada con la pila estándar del fabricante. | Exigida por fuente + decisión | JLCPCB: 4 capas, 1,6 mm, interno 0,5 oz por defecto (1 oz opcional), ENIG, impedancia ±10 %. | Condición de pedido / Layer Stack Manager (guía siguiente). | Pendiente: definir pila exacta.
PCB-30 | RNF-15 | Puntos de prueba (pad ≥1,0 mm) en 3V3_SW_OBC, 5V_SW_ADCS, 3V3_SW_CAM, GND×2, NRST, OBC_HB, I2C1, UART5; J9 accesible desde el borde. | Recomendación adoptada | Prueba de la tarjeta aislada (RNF-15). | Componentes TP en el esquemático. | Estado: definido.

Sheet: Fabricacion
Parámetro | Valor adoptado / capacidad | Observación
Proveedor | JLCPCB – Rigid PCB capabilities | https://jlcpcb.com/capabilities/Capabilities
Fecha de consulta | 2026-10-07
Capas | 4 (señal / GND / 3V3 / señal) | Disponible 1–32
Material | FR-4 | Laminados grado A (Nan Ya, KB, Shengyi)
Espesor | 1,6 mm ±10 % | 0,4–2,0 mm estándar
Cobre | Externo 1 oz; interno 1 oz | Interno 0,5 oz por defecto, 1 oz opcional
Acabado | ENIG | Requerido para pads BGA 0,2–0,25 mm
Impedancia | Controlada ±10 % con pila estándar del fabricante | Calculadora JLCPCB
Pista/espacio mín. | 0,09/0,09 mm (multicapa, 1 oz); 3 mil en fanout BGA | Se adopta 0,10/0,10 general
Vía mín. | 0,15/0,25 mm (taladro/diámetro); preferido taladro ≥0,2 mm | Se adopta 0,30/0,50 general y 0,20/0,40 en BGA
Anillo PTH | Rec. 0,20 mm, mín. 0,15 mm (multicapa 1 oz)
Pad-pista / pad-pad SMD | 0,10 mm / 0,15 mm
Puente de máscara | 0,10 mm (verde) | LQFP 0,5 mm compatible
Vía en pad | Rellena con epoxi y tapada (0,15–0,55 mm) | Servicio especial para eMMC
Cobre a borde | ≥0,2 mm ruteado | Se adopta 0,5 mm
Serigrafía | Alto ≥1,0 mm, trazo ≥0,15 mm, ≥0,15 mm a pads
Tolerancia de agujero | +0,13/−0,08 mm (PTH)
Servicios especiales | ENIG + vía en pad rellena y tapada + vía 0,2 mm con diámetro <0,45 mm (costo extra)

Sheet: Directivas_Altium
Clase / directiva | Redes | Regla o mecanismo | Restricciones
PWR_3V3 | 3V3_SW_OBC, 3V3_SW_CAM, VDDA | Net Class + Width (mín 0,5 mm, pref 1,0) | PCB-01
PWR_5V | 5V_SW_ADCS (incluye VM de los DRV8837) | Net Class + Width (mín 0,5 mm) | PCB-02
SDRAM | SDRAM_D[0..15], SDRAM_A[0..12], SDRAM_BA0/1, SDRAM_NBL0/1, SDRAM_SDCLK, SDRAM_SDNRAS, SDRAM_SDNCAS, SDRAM_SDNWE, SDRAM_SDNE0, SDRAM_SDCKE0 | Net Class + Width 0,35 mm + Matched Lengths 10 mm | PCB-08, PCB-09
DCMI | DCMI_D[0..11], DCMI_PIXCLK, DCMI_HSYNC, DCMI_VSYNC | Net Class + Matched Lengths 10 mm | PCB-11
SDMMC | EMMC_CK, EMMC_CMD, EMMC_D[0..3] | Net Class + Matched Lengths 5 mm | PCB-12
QSPI | QSPI_CLK, QSPI_NCS, QSPI_IO[0..3] | Net Class | PCB-13
MTQ | MTQ_COILA[1..3], MTQ_COILB[1..3] | Net Class + Width 0,25 mm | PCB-17
SUN_AN | SUNA[1..4], SUNB[1..4], SUNC[1..4], SUND[1..4] | Net Class + Clearance 0,3 mm | PCB-18
VCAP | VCAP | Net Class + Width 0,3 mm | PCB-05
Notas | — | Notas de esquemático: PCB-03, 04, 06, 07, 10, 16, 19, 20, 23, 24 | —
Pendientes en PCB | — | PCB-14 (fanout BGA), 15, 25–29 (reglas del fabricante y pila) | —

Sheet: Ciclo_de_vida
Verificación de ciclo de vida de la BOM (2026-10-25). Regla: solo componentes activos (no NRND, no obsoletos, no LTB).
Ref. | Referencia | Estado | Fuente y fecha | Disponibilidad / nota
U1 | STM32H743IIT6 | Activo | st.com, página STM32H743II (2026-10-25): «Active, in volume production», longevidad 10 años desde 2026-01-01 (hasta 01/2036) | DigiKey, Future, RS
U2 | IS42S16160L-6TLI | Activo | DigiKey 706-IS42S16160L-6TLI (2026-10-25): Product status Active | 33 u en DigiKey; reservar con anticipación para el lote de 1000
U3 | IS21EF04GP-JQLI (reemplaza ASFC4G31MA-51BIN) | Activo | Suntsu (Active, 312 u, 2026-10-26); misma familia que IS21EF04GP-JCLI (Arrow: Active). El ASFC4G31MA-51BIN es Obsoleto en Octopart (LTB 2026-06-30) | Plazo de fábrica 52 semanas; precio por RFQ (C-10)
U4 | W25Q128JVSIQ | Activo | DigiKey W25Q128JVSIQ-ND (2026-10-25): Active | 27.875 u en DigiKey
U5 | ISM330DHCXTR | Activo | st.com (2026-10-25): Active; longevidad 10 años desde 2023-01-01 (hasta 01/2033) | —
U6 | LIS2MDLTR | Activo | st.com (2026-10-25): Active, in volume production | —
U7 | RV-3032-C7-32.768KHZ-2.5PPM-TA-QC | Activo | Dasenic (variante TA-QA, misma familia): Active, 11.467 u; JLCPCB C5127802 listado | —
U8–U10 | DRV8837DSGR | Activo | Digipart (2026-10-25): Part Status Active (TI) | Newark 1.381 u
U11–U13 | INA180A2IDBVR | Activo | ti.com, part details (2026-10-25): ACTIVE | —
Y1 | ECS-250-8-33-JGN-TR | Activo | Future Electronics (2026-10-25): Active; Mouser stock 3.669 | —
J1, J2 | ESQ-126-39-G-D | Activo (pedido a fábrica) | Farnell 3550766: «Available to order», plazo de fábrica 6 semanas; DigiKey 616 u, Arrow 250 u (Mymectronic) | La ficha de Master Electronics muestra a la vez todos los mensajes de estado (plantilla), con stock y plazo de fábrica de 2 semanas: no indica fin de vida
J3 | FH12-40S-0.5SH(55) | Activo | Hirose, inventario global (2026-10-25): DigiKey 18.576, Mouser 25.836, Future 22.000 u; Farnell orderable | —
J4–J8 | SM08B-GHS-TB(LF)(SN) | Activo | Future Electronics (2026-10-25): Active | —
J9 | FTSH-105-01-L-DV-K | Activo (pedido a fábrica) | LCSC C448647 (variante -TR): 1.016 u en stock, 2026-10-26 | Si se requiere carrete: FTSH-105-01-F-DV-TR (mismo plano)
MCU_CORE C1, C2, C3, C4, C5, C6, C7, C8, C9, C10, C11, C12, | CL05B104KO5NNNC (Samsung Electro-Mechanics) | Activo / en stock | LCSC C1525: Activo: LCSC 5.372.800 u | —
MCU_CORE C24, C25 | GJM1555C1H6R8CB01D (Murata) | Activo / en stock | LCSC C88897: En stock: LCSC 3.150 u | —
ADCS_SENS C5 | CL05B224KO5NNNC (Samsung Electro-Mechanics) | Activo / en stock | LCSC C16772: En stock: LCSC ≈834.000 u | —
MCU_CORE C19, C21; MEMORY C10 | CL10B105KO8NNNC (Samsung Electro-Mechanics) | Activo / en stock | LCSC C59782: En stock: LCSC 149.850 u | —
MCU_CORE C17, C18 | CL10B225KP8NNNC (Samsung Electro-Mechanics) | Activo / en stock | Future Electronics (cinta cortada / carrete 4000), 2026-10-26: Activo (Future): 22.978 u en cinta, 528.000 en carrete | —
MCU_CORE C15 | CL21B475KOFNNNE (Samsung Electro-Mechanics) | Activo / en stock | Future Electronics (carrete 2000), 2026-10-26: Activo (Future): 440.000 u | —
PWR_IN C1, C2, C3 | CL21B106KOQNNNE (Samsung Electro-Mechanics) | Activo / en stock | LCSC C95841: En stock: LCSC 37.300 u | —
MEMORY R1 | RC0402FR-0722RL (YAGEO) | Activo / en stock | LCSC C114765: En stock: LCSC 2.286.800 u | —
MCU_CORE R1 | RC0402FR-0747RL (YAGEO) | Activo / en stock | LCSC C137973: Listado en LCSC (C137973) | —
PANEL_CH R1×4, R2×4, R3×4, R4×4 | 0402WGF1001TCE (UNI-ROYAL) | Activo / en stock | LCSC C11702: En stock: LCSC 7.159.100 u | —
ADCS_SENS R2, R3 | RC0402FR-072K2L (YAGEO) | Activo / en stock | LCSC C114762: En stock: LCSC 935.200 u | —
CAM_IF R1, R2; BUS_IF R1, R2 | RC0402FR-074K7L (YAGEO) | Activo / en stock | LCSC C105871: En stock: LCSC 8.008.500 u | —
MCU_CORE R2; MEMORY R2, R3, R4, R5, R6, R7; ADCS_SENS R1, R4 | RC0402FR-0710KL (YAGEO) | Activo / en stock | LCSC C60490: En stock: LCSC 13.500 u | —
MCU_CORE R3; CAM_IF R3; BUS_IF R3, R4 | RC0402FR-07100KL (YAGEO) | Activo / en stock | LCSC C60491: En stock: LCSC 8.240.100 u | —
MTQ_CH R1×3 | RL0603FR-070R47L (YAGEO) | Activo; sin stock hoy | LCSC C326953: Sin stock en LCSC ni RS (RS: reposición 2027-02-09); alternativa con stock: UNI-ROYAL 0603WAF470LT5E | Usar la alternativa indicada si no hay reposición antes de comprar
MCU_CORE FB1 | BLM15AG601SN1D (Murata) | Activo / en stock | LCSC C76884: En stock: LCSC 1.353.700 u | —

Sheet: BOM
Designadores | Cant/tarjeta | Descripción | Fabricante | MPN | Encapsulado | Proveedor | Estado de cotización
U1 | 1 | MCU Cortex-M7 2 MB/1 MB | STMicroelectronics | STM32H743IIT6 | LQFP-176 24×24 | DigiKey 497-17722-ND | Cotizado (10 u); 100/1000 sin escala publicada → se usa 10 u
U2 | 1 | SDRAM 256 Mb ×16 166 MHz | ISSI | IS42S16160L-6TLI | TSOP-II-54 | DigiKey 706-IS42S16160L-6TLI-ND | Cotizado
U3 | 1 | eMMC 5.1 4 GB pSLC industrial | ISSI | IS21EF04GP-JQLI | 100-LFBGA 14×18 | Suntsu / Avnet (RFQ, 2026-10-26) | Activo (Suntsu: 312 u, 2026-10-26); precio sin publicar (RFQ): se usa provisionalmente el precio verificado de la eMMC anterior de igual capacidad
U4 | 1 | NOR QSPI 128 Mb | Winbond | W25Q128JVSIQ | SOIC-8 208 mil | DigiKey W25Q128JVSIQ-ND | Cotizado
U5 | 1 | IMU 6 ejes industrial | STMicroelectronics | ISM330DHCXTR | LGA-14 2,5×3 | DigiKey 497-19784-1-ND | Cotizado (1000 u vía zenode/DigiKey)
U6 | 1 | Magnetómetro 3 ejes | STMicroelectronics | LIS2MDLTR | LGA-12 2×2 | Newark 07AH6648 | Cotizado
U7 | 1 | RTC compensado I2C | Micro Crystal | RV-3032-C7-32.768KHZ-2.5PPM-TA-QC | SON-8 3,2×1,5 | DigiKey / JLCPCB C5127802 | Cotizado (1000 u: JLCPCB)
U8–U10 | 3 | Puente H 1,8 A | Texas Instruments | DRV8837DSGR | WSON-8 2×2 | Mouser 595-DRV8837DSGR | Cotizado
U11–U13 | 3 | Amplificador de corriente G=50 | Texas Instruments | INA180A2IDBVR | SOT-23-5 | DigiKey 296-47653-1-ND | Cotizado (sin escala 1000 → se usa 100 u)
Y1 | 1 | Cristal 25 MHz 8 pF ±20 ppm, −40…85 °C | ECS Inc. | ECS-250-8-33-JGN-TR | SMD 3,2×2,5 (4 pads) | Mouser (ECS-250-8-33-JGN-TR), 2026-10-25 | Cotizado; stock 3.669
J1, J2 | 2 | Conector apilado PC/104 2×26 | Samtec | ESQ-126-39-G-D | THT 2,54 mm | Master Electronics | Cotizado (mínimo 5)
J3 | 1 | Conector FFC 40 pos 0,5 mm | Hirose | FH12-40S-0.5SH(55) | SMD R/A | Farnell 1324556 | Cotizado (EUR)
J4–J8 | 5 | Conector GH 8 pos 1,25 mm | JST | SM08B-GHS-TB(LF)(SN) | SMD R/A | RS 175-5600 | Cotizado (paquete de 10)
J9 | 1 | Cabecera SWD 10 pos 1,27 mm | Samtec | FTSH-105-01-L-DV-K | SMD 2×5, 1,27 mm, polarizado | LCSC C448647 (FTSH-105-01-L-DV-K-TR), 2026-10-26 | Cotizado: 1+ 1,5448 USD; 1100+ 0,9729 USD; stock 1.016
MCU_CORE C1, C2, C3, C4, C5, C6, C7, C8, C9, C10, C11, C12, C13, C14, C16, C20, C22, C23; MEMORY C1, C2, C3, C4, C5, C6, C7, C8, C9, C11; ADCS_SENS C1, C2, C3, C4, C6; MTQ_CH C1×3, C2×3, C3×3; PANEL_CH C1×4, C2×4, C3×4, C4×4 | 58 | MLCC 100 nF ±10 % 16 V X7R | Samsung Electro-Mechanics | CL05B104KO5NNNC | 0402 | LCSC C1525 | Cotizado (escalas publicadas)
MCU_CORE C24, C25 | 2 | MLCC 6,8 pF ±0,25 pF 50 V C0G (carga del HSE) | Murata | GJM1555C1H6R8CB01D | 0402 | LCSC C88897 | Estimado: solo «desde 0,008 USD» publicado (precio de la escala más alta)
ADCS_SENS C5 | 1 | MLCC 220 nF ±10 % 16 V X7R (C1 del LIS2MDL) | Samsung Electro-Mechanics | CL05B224KO5NNNC | 0402 | LCSC C16772 | Estimado: solo «desde 0,0027 USD» publicado
MCU_CORE C19, C21; MEMORY C10 | 3 | MLCC 1 µF ±10 % 16 V X7R (VDDA, VREF+, VDDi) | Samsung Electro-Mechanics | CL10B105KO8NNNC | 0603 | LCSC C59782 | Estimado: solo «desde 0,0097 USD» publicado
MCU_CORE C17, C18 | 2 | MLCC 2,2 µF ±10 % 10 V X7R, ESR <0,1 Ω (VCAP) | Samsung Electro-Mechanics | CL10B225KP8NNNC | 0603 | Future Electronics (cinta cortada / carrete 4000), 2026-10-26 | Cotizado: cinta 0,39 USD; carrete 4000 u 0,093 USD
MCU_CORE C15 | 1 | MLCC 4,7 µF ±10 % 16 V X7R (bulk del MCU) | Samsung Electro-Mechanics | CL21B475KOFNNNE | 0805 | Future Electronics (carrete 2000), 2026-10-26 | Estimado: Future solo vende carretes de 2000 u (0,168 USD); se usa el precio del CL21B106KOQNNNE de la misma serie para no cargar 1999 u sobrantes al lote de 10
PWR_IN C1, C2, C3 | 3 | MLCC 10 µF ±10 % 16 V X7R (entrada de rieles 3V3 y 5V) | Samsung Electro-Mechanics | CL21B106KOQNNNE | 0805 | LCSC C95841 | Estimado: solo «desde 0,0463 USD» publicado
MEMORY R1 | 1 | Resistencia 22 Ω ±1 % 62,5 mW (serie EMMC_CK) | YAGEO | RC0402FR-0722RL | 0402 | LCSC C114765 | Cotizado (escalas publicadas)
MCU_CORE R1 | 1 | Resistencia 47 Ω ±1 % 62,5 mW (filtro VREF+) | YAGEO | RC0402FR-0747RL | 0402 | LCSC C137973 | Estimado: precio del RC0402FR-0722RL (misma serie)
PANEL_CH R1×4, R2×4, R3×4, R4×4 | 16 | Resistencia 1 kΩ ±1 % 62,5 mW (filtro solar) | UNI-ROYAL | 0402WGF1001TCE | 0402 | LCSC C11702 | Cotizado (escalas publicadas)
ADCS_SENS R2, R3 | 2 | Resistencia 2,2 kΩ ±1 % 62,5 mW (pull-up I2C2) | YAGEO | RC0402FR-072K2L | 0402 | LCSC C114762 | Cotizado (escalas publicadas)
CAM_IF R1, R2; BUS_IF R1, R2 | 4 | Resistencia 4,7 kΩ ±1 % 62,5 mW (pull-up I2C1, I2C3) | YAGEO | RC0402FR-074K7L | 0402 | LCSC C105871 | Cotizado (escalas publicadas)
MCU_CORE R2; MEMORY R2, R3, R4, R5, R6, R7; ADCS_SENS R1, R4 | 9 | Resistencia 10 kΩ ±1 % 62,5 mW (pull-ups, BOOT0) | YAGEO | RC0402FR-0710KL | 0402 | LCSC C60490 | Cotizado (escalas publicadas)
MCU_CORE R3; CAM_IF R3; BUS_IF R3, R4 | 4 | Resistencia 100 kΩ ±1 % 62,5 mW (pull-downs de habilitación) | YAGEO | RC0402FR-07100KL | 0402 | LCSC C60491 | Cotizado (escalas publicadas)
MTQ_CH R1×3 | 3 | Resistencia shunt 0,47 Ω ±1 % 100 mW (medición MTQ) | YAGEO | RL0603FR-070R47L | 0603 | LCSC C326953 | Estimado: «desde 0,0113 USD»; sin stock en LCSC hoy (alternativa: UNI-ROYAL 0603WAF470LT5E, mismo valor y encapsulado)
MCU_CORE FB1 | 1 | Ferrita 600 Ω @100 MHz, 300 mA, 0,52 Ω DC (VDDA) | Murata | BLM15AG601SN1D | 0402 | LCSC C76884 | Cotizado (escalas publicadas)
Configuración: variante única, todos los componentes montados; no hay componentes opcionales ni DNP. TP1–TP11 son pads de prueba sin componente. Designadores del esquemático de referencia (hoja:designador; ×3 = canal MTQ repetido, ×4 = canal PANEL repetido); al anotar en Altium se reemplazan por los definitivos.
Total de componentes montados por tarjeta | 134

Sheet: Costos
Tasa EUR→USD | 1.1559
TRM COP por USD | 3158.43
Componente | Cant/tarjeta | Moneda | Mínimo | Múltiplo | Q1 | Q2 | Q3 | Q4 | Q5 | Q6 | Q7 | Q8 | P1 | P2 | P3 | P4 | P5 | P6 | P7 | P8 | Lote 10: compra | Precio u (USD) | Costo | Sobrante | Lote 100: compra | Precio u (USD) | Costo | Sobrante | Lote 1000: compra | Precio u (USD) | Costo | Sobrante
STM32H743IIT6 | 1 | USD | 1 | 1 | 10 | 1000000000 | 1000000000 | 1000000000 | 1000000000 | 1000000000 | 1000000000 | 1000000000 | 14.0300 | 14.0300 | 14.0300 | 14.0300 | 14.0300 | 14.0300 | 14.0300 | 14.0300 | 10 | 14.0300 | 140.30 | 0 | 100 | 14.0300 | 1403.00 | 0 | 1000 | 14.0300 | 14030.00 | 0
IS42S16160L-6TLI | 1 | USD | 1 | 1 | 1 | 10 | 25 | 50 | 100 | 250 | 500 | 1000 | 4.9400 | 4.6030 | 4.4656 | 4.3616 | 4.2577 | 4.1211 | 4.0189 | 3.9181 | 10 | 4.6030 | 46.03 | 0 | 100 | 4.2577 | 425.77 | 0 | 1000 | 3.9181 | 3918.08 | 0
IS21EF04GP-JQLI (precio provisional) | 1 | USD | 1 | 1 | 1 | 10 | 100 | 1000 | 1000000000 | 1000000000 | 1000000000 | 1000000000 | 40.9500 | 39.6200 | 39.0000 | 39.0000 | 39.0000 | 39.0000 | 39.0000 | 39.0000 | 10 | 39.6200 | 396.20 | 0 | 100 | 39.0000 | 3900.00 | 0 | 1000 | 39.0000 | 39000.00 | 0
W25Q128JVSIQ | 1 | USD | 1 | 1 | 1 | 10 | 25 | 90 | 180 | 270 | 540 | 1080 | 1.8800 | 1.7620 | 1.7116 | 1.6407 | 1.6022 | 1.5797 | 1.5414 | 1.5035 | 10 | 1.7620 | 17.62 | 0 | 100 | 1.6407 | 164.07 | 0 | 1000 | 1.5414 | 1541.44 | 0
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
Tamaño del lote | Costo de componentes del lote (USD) | Costo por tarjeta (USD) | Observaciones | Costo del lote (COP) | Costo por tarjeta (COP)
10 tarjetas | 1102.896015 | 110.2896015 | Mínimos de compra (100 u en pasivos de LCSC, 5 u en ESQ-126, paquetes de 10 en JST) generan sobrantes (columna Sobrante). | 3483419.861 | 348341.9861
100 tarjetas | 9899.8683 | 98.998683 | La mayoría de los circuitos integrados ya están en su escala de 100 u. | 31268041.03 | 312680.4103
1000 tarjetas | 94076.881 | 94.076881 | MCU, INA180, FTSH y eMMC sin escala de 1000 publicada: se mantiene el último precio (conservador). | 297135243.3 | 297135.2433
Precios cotizados en su moneda original (USD o EUR, columna C); EUR→USD con B1 y USD→COP con B2. No incluye fabricación de la PCB, ensamble, transporte ni impuestos.
Configuración de costo: variante única, todos los componentes montados (sin DNP). Los puntos de prueba TP son pads de cobre, sin componente ni costo.
Pasivos «Estimado»: LCSC solo publica el precio de su escala más alta («desde»); en el 100 nF, cuyas escalas sí están publicadas, el precio de 100 u es 1,8 veces el «desde». El efecto sobre el costo por tarjeta es menor de 0,1 USD.

Sheet: Fuentes
Notas de fuentes verificadas (enlaces y datos usados)
# Notas de fuentes verificadas (Práctica 4, P2 OBC-ADCS) — consulta 2026-10-07
- STM32H743IIT6 (ST, DS12110): Cortex-M7, LQFP176 24x24, 1.62-3.6 V, -40..85 C, 2 MB flash, 1 MB RAM (192k TCM, 864k SRAM, 4k backup),
FMC SDRAM hasta 133 MHz (sinc.), QUADSPI 133 MHz, DCMI 8-14 bit hasta 80 MHz, 3 ADC 16-bit, 140 I/O, 4 USART + 4 UART, 6 SPI, 4 I2C, 2 SDMMC.
400 MHz/856 DMIPS (rev Y); 480 MHz/1027 DMIPS (rev V). DigiKey 497-17722-ND: 10 u = $14.03 (MX); TME 1 u 14.97 EUR. Lead 15 sem.
- SDRAM ISSI IS42S16160L-6TLI (sustituye J, J-6TL obsoleto): 256 Mb 16Mx16, 166 MHz, 5.4 ns, 3.0-3.6 V, -40..85, TSOP-II 54 (10.16 mm).
DigiKey 706-IS42S16160L-6TLI-ND: 1 $4.94, 10 $4.603, 25 $4.4656, 50 $4.3616, 100 $4.2577, 250 $4.12112, 500 $4.01894, 1000 $3.91808. Stock 33.
Refresh 8K / 64 ms (industrial).
- eMMC Alliance Memory ASFC4G31M-51BIN: 4 GB eMMC 5.1, MLC, VCC 2.7-3.6, VCCQ 1.7-1.95 o 2.7-3.6, -40..85, FBGA-153 (11.5x13), bus 1/4/8 bit, 0-200 MHz.
Future Electronics (4155744): 1 $4.57, 10 $4.48, 25 $4.41, 75 $4.33, 150+ $4.23; tray 160; stock 773. Alt: Kingston EMMC04G-WT32-01G10 $59.69 (1).
- QSPI NOR Winbond W25Q128JVSIQ: 128 Mb, 133 MHz, 2.7-3.6 V, -40..85, SOIC-8 208 mil. DigiKey W25Q128JVSIQ-ND (USD): 1 $1.88, 10 $1.762, 25 1.7116,
90 1.64067, 180 1.60217, 270 1.5797, 540 1.54144, 1080 1.50348, 5040 1.42083; tube 90; stock 27,875.
- IMU ST ISM330DHCXTR: 6 ejes, I2C/SPI, -40..105 C, LGA-14 2.5x3. DigiKey 497-19784-1-ND: 10 $6.756, 100 $5.9632 (digikey.com); 1000 $4.99 (DigiKey via zenode.ai).
- Magnetometro ST LIS2MDLTR: 3 ejes, ±50 G, 1.71-3.6 V, -40..85, LGA-12. Newark 07AH6648: 10+ $2.71, 100+ $2.35, 1000+ $2.08.
(LIS3MDL descartado: NRND en ST, obsoleto en DigiKey.)
- RTC Micro Crystal RV-3032-C7-32.768KHZ-2.5PPM-TA-QC: compensado en T, ±1.5 ppm (0..50 C), ±2.5 ppm (-40..85 C), 160 nA, 1.3-5.5 V, I2C 400 kHz,
CLKOUT 1 Hz-52 MHz, backup switchover, 3.2x1.5 mm. DigiKey: 10 $2.38, 100 $1.9573; JLCPCB C5127802: 1000+ $2.023.
- AN4938 (ST) via resumen UWARG: VDD 4.7 uF bulk + 100 nF por pin VDD; VDDA 1 uF + 100 nF, ferrita desde VDD; VREF+ 1 uF + 100 nF (47 ohm desde VDDA);
VCAP1 y VCAP2 2.2 uF ESR<100 mohm c/u, VCAP3 unido a los otros sin cap extra [aplica a encapsulados con VCAP3; el LQFP176 solo tiene VCAP en pines 81 y 125]; VDDLDO 4.7 uF. URL AN4938:
https://www.st.com/resource/en/application_note/an4938-getting-started-with-stm32h74xig-and-stm32h75xig-hardware-development-stmicroelectronics.pdf
- Consumo STM32H7 (Emcraft SOM, según datasheet STM32H75xB): Run 400 MHz todos los periféricos 220 mA máx @3.3 V; QSPI NOR 28 mA (80 MHz DTR, MT25QL512);
SDRAM 2x32MB 120 mA burst @143 MHz (AS4C32M16SA) -> ~60 mA/chip. https://www.emcraft.com/som/stm32h7/STM32H7-SOM-CURRENT_CONSUMPTION.pdf
- IS42S16160J (Arrow): operating current 140 mA (dato de distribuidor).
- eMMC ASFC: Tabla 4 'Current Consumption' en hoja de datos (no legible en búsqueda) -> estimación declarada.
- DRV8837DSGR (TI): H-bridge, VCC 1.8-7 V, VM 0-11 V, 1.8 A, -40..85, WSON-8 2x2 (PAD). Mouser 595-DRV8837DSGR: 10 $0.623, 100 $0.493, 1000 $0.405 (oemstrade 2026). DigiKey US: 10 $0.79, 100 $0.6299.
- Samtec ESQ-126-39-G-D: PC/104 socket 2x26, 2.54 mm, THT, 5.7 A/contacto (dato distribuidor), -55..125 C. Master Electronics (USD): 5 $12.96, 25 $11.40, 50 $10.88,
100 $9.88, 250 $8.98, 500 $8.59, 1000+ $8.56; mín 5. Stock 254.
- Hirose FH12-40S-0.5SH(55): FFC 40 pos 0.5 mm, contacto inferior, flip lock, 0.5 A/contacto, 50 V, -40..85, FFC 0.3 mm. Farnell (EUR): 1 2.79, 10 1.89, 100 1.79,
250 1.68, 500 1.60, 1000 1.51. Stock 707.
- JST SM08B-GHS-TB(LF)(SN): GH 1.25 mm, 8 pos SMD R/A, 1 A, 50 V, -25..85 C. RS 175-5600 (EUR): 10-40 0.578, 50-90 0.539, 100-240 0.509, 250-490 0.48, 500+ 0.456.
- JLCPCB capacidades (https://jlcpcb.com/capabilities/Capabilities, consulta 2026-10-07):
capas 1-32; impedancia controlada ±10% (4/6+ capas); FR-4 Tg; espesores 0.4/0.6/0.8/1.0/1.2/1.6/2.0 mm, tol ±10% (>=1 mm);
cobre externo multicapa 1 oz/2 oz; interno 0.5 oz por defecto (1/2 oz opc.); acabados HASL/ENIG/OSP.
Drill multicapa 0.15-6.3 mm; via mín 0.15/0.25 mm (preferido hole 0.2 mm; 0.2/0.25 mm con diámetro <0.45 mm cuesta más) -> via estándar 0.3/0.45...
(regla: diámetro via >= hole + 0.1 mm, pref +0.15). Tolerancia agujero +0.13/-0.08; posición ±0.075.
Traza/esp mín multicapa 1 oz: 0.09/0.09 mm (3 mil en fanout BGA); 2 oz: 0.15/0.15. Tolerancia ancho ±20%.
Anillo PTH multicapa 1 oz: rec 0.20, mín abs 0.15 mm. BGA pad 0.2-0.25 mm requiere ENIG; pad BGA-pista >=0.1 (0.09 mín); via-in-pad rellena y tapada disponible.
Pad-pista 0.1 mm; pad SMD-pad 0.15 mm; via-pista 0.2; PTH-pista 0.28 (0.35 rec); NPTH-pista 0.2; inner via hole-cobre 0.2; inner PTH-cobre 0.3.
Máscara 1:1 (LDI); 0.09 mm apertura-pista vecina; puente máscara 0.10 mm (verde) / 0.13 (negro/blanco); vias tapadas <=0.5 mm, 0.35 mm de aperturas.
Serigrafía línea >=0.15, alto >=1.0 mm, pad-serigrafía 0.15. Borde ruteado: cobre >=0.2 mm; V-cut >=0.4 mm. Hole-to-hole vias 0.2; pads 0.45.
Dk prepreg 7628: 4.4; 3313: 4.1; 2116: 4.16. Soldermask Dk 3.8.
- INA180A2IDBVR (TI): ganancia 50 V/V ±1%, CM -0.2..26 V, VS 2.7-5.5 V, 260 uA, 350 kHz, -40..125, SOT-23-5. DigiKey US: 10 $0.31, 100 $0.2397. Mouser: 10 $0.218, 100 $0.167.
- Samtec FTSH-105-01-F-DV: 10 pos 1.27 mm SMD (Cortex debug), 3.4 A, LCP -55..125. Findchips (distribuidor): 10 $0.801, 100 $0.757.
- Decisión: sin load-switch en P2 (la P4 recibe 3V3_SW/5V_SW conmutados por P1 a través del bus).
- Abracon ABM8-25.000MHZ-D2Y-T: 25 MHz ±20 ppm tol, ±30 ppm estab., CL 18 pF, ESR 50 ohm, -40..85, 3.2x2.5. DigiKey 535-13419-1-ND: 1 $0.58, 25 $0.456.
- Samsung CL05B104KO5NNNC 100 nF X7R 16 V 0402: LCSC C1525: 100+ $0.0013, 1000+ $0.001, 3000+ $0.0009, 10000+ $0.0008 (mín 100, múltiplo 100).
- EUR/USD 1.1559 (currencyconvert.online, 2026-08-09) -> parámetro editable.
- NXP UM10204 I2C (rev.7): tr max 1000 ns Sm / 300 ns Fm; Rp(max)=tr/(0.8473 Cb); Rp(min)=(VDD-VOL)/IOL (3 mA). https://www.nxp.com/docs/en/user-guide/UM10204.pdf
- eMMC ASFC4G31MA-51BIN (2026-10-24): datasheet Alliance Rev 1.0 feb. 2025 https://www.alliancememory.com/wp-content/uploads/AllianceMemory_4GB_ASFC4G31MA-51BIN_eMMC_datasheet_Feb2025_V1.0.pdf ; 4 GB eMMC 5.1, VCC 2.7–3.6 V, VCCQ 1.7–1.95 o 2.7–3.6 V, −40…85 °C, VFBGA-153 11.5×13×0.8 paso 0.5; Tabla 20 RCMD 4.7–100k, RDAT 10–100k; Tabla 4 hasta 92 mA ICC y 145 mA ICCQ. Octopart: Future 1 $40.95, 10 $39.62, 100+ $39.00 (stock 15); estado obsoleto, LTB 2026-06-30. ASFC4G31M-51BIN: obsoleto, LTB 2025-06-03.
- Verificación con hojas de datos (2026-10-25): DS12110 Rev 11 (ene. 2026); AN4938 Rev 7 (oct. 2024); AN2867 Rev 24 (feb. 2026); IS42S16160L Rev. A (21-04-2025); ASFC4G31MA-51BIN Rev 1.0 (feb. 2025); W25Q128JV Rev J (25-04-2024); ISM330DHCX DS13012 Rev 7 (nov. 2020); LIS2MDL DS12144 Rev 6 (jul. 2024); RV-3032-C7 datasheet v1.4 (11.2022); DRV8837 SLVSBA4F (abr. 2021); INA180 SBOS741H (jul. 2022); ABM8 (08.19.15); ESQ Rev CM; FTSH Rev BU; FH12 (01-10-2026); UM10204 Rev 7.0 (01-10-2021).
- ECS-250-8-33-JGN-TR: ecsxtal.com (ECX-32, Rev 2021): CL 8 pF, ESR 40 Ω (24–54 MHz), C0 5 pF, −40…85 °C (opción N); Mouser: 1 $0.45, 10 $0.353, 100 $0.32, 500 $0.307, 1000 $0.285 (reel); stock 3.669 (2026-10-25).
- Asignación de pines (consulta 2026-10-08): STMicroelectronics, STM32_open_pin_data, https://github.com/STMicroelectronics/STM32_open_pin_data — mcu/STM32H743IITx.xml (LQFP176: 140 E/S, solo VCAP en pines 81 y 125, PC2_C/PC3_C) y mcu/IP/GPIO-STM32H747_gpio_v1_0_Modes.xml (números AF).
- C-10 eMMC ISSI IS21EF04GP-JCLI: datasheet IS21/22EF04GP/08GP Rev. A2 (30-05-2024) https://www.ickey.cn/static-pf/datasheet/a9/08/de44/a908de447eda0a763ac551e02727ee34.pdf ; Arrow https://www.arrow.com/en/products/is21ef04gp-jcli/integrated-silicon-solution-inc ; Suntsu https://suntsu.com/product/integrated-circuits/memory/flash-memory/is21ef04gp-jcli-tr/ (Active, 1.333 u, 2026-10-24). Sin precio publicado: costo provisional = precio verificado del ASFC4G31MA-51BIN (Future, 2026-10-24).
- Ciclo de vida (2026-10-25): hoja Ciclo_de_vida, con la fuente de cada componente.
