DuvanRamirez/CubeSat_UD34/(list of files, drawings)

Other design files:
P2 – OBC-ADCS/Altium/P2_OBC-ADCS CubeSat/ADCS_SENS.SchDoc
P2 – OBC-ADCS/Altium/P2_OBC-ADCS CubeSat/BUS_IF.SchDoc
P2 – OBC-ADCS/Altium/P2_OBC-ADCS CubeSat/CAM_IF.SchDoc
P2 – OBC-ADCS/Altium/P2_OBC-ADCS CubeSat/MCU_CORE.SchDoc
P2 – OBC-ADCS/Altium/P2_OBC-ADCS CubeSat/MEMORY.SchDoc
P2 – OBC-ADCS/Altium/P2_OBC-ADCS CubeSat/MTQ_CH.SchDoc
P2 – OBC-ADCS/Altium/P2_OBC-ADCS CubeSat/P2_OBC-ADCS CubeSat - Copy.PrjPcb
P2 – OBC-ADCS/Altium/P2_OBC-ADCS CubeSat/P2_TOP.SchDoc
P2 – OBC-ADCS/Altium/P2_OBC-ADCS CubeSat/PANEL_CH.SchDoc
P2 – OBC-ADCS/Altium/P2_OBC-ADCS CubeSat/PWR_IN.SchDoc
