DuvanRamirez/CubeSat_UD34/(commit log)

2026-09-29 Hoja de calculo
    [Hoja_Calculo.xlsx]
2026-10-27 Proyecto de Altium
